iduwhux/drsstc2/tesla_coil_schematic_sketch.pdf

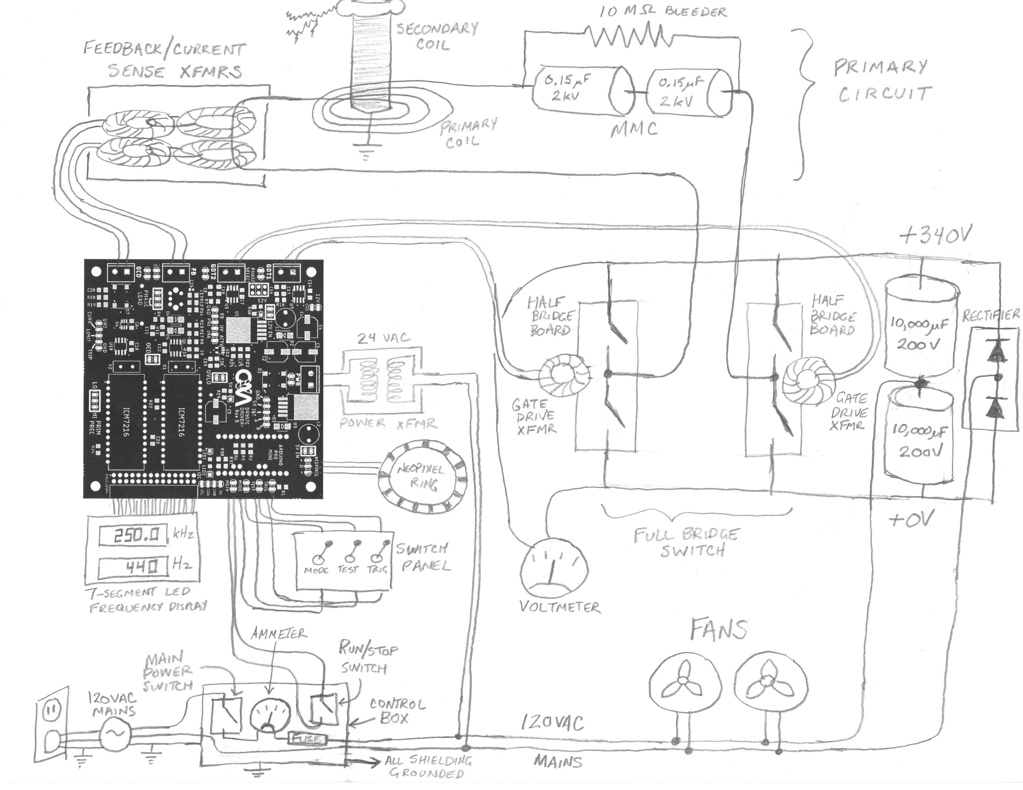
[picture p1: page 1]
