iduwhux/drsstc2/tesla_coil_front_panel_diagram.pdf

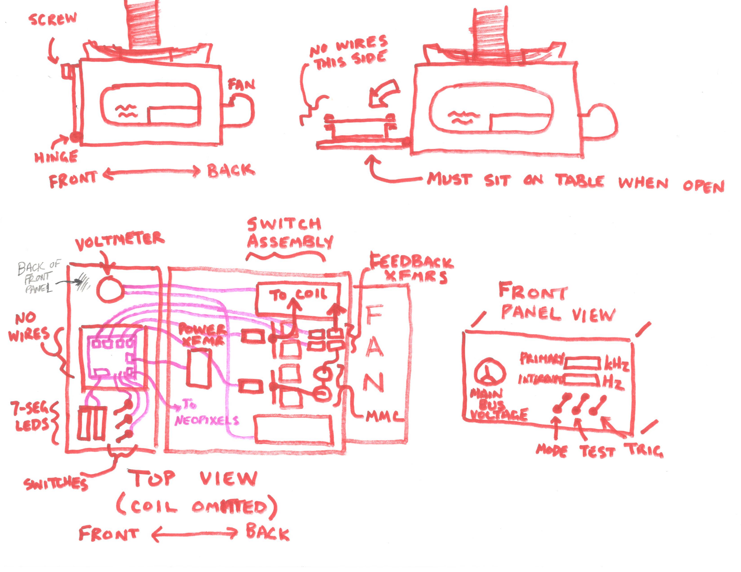
[picture p2: page 1]
