iduwhux/drsstc2/drsstc.png

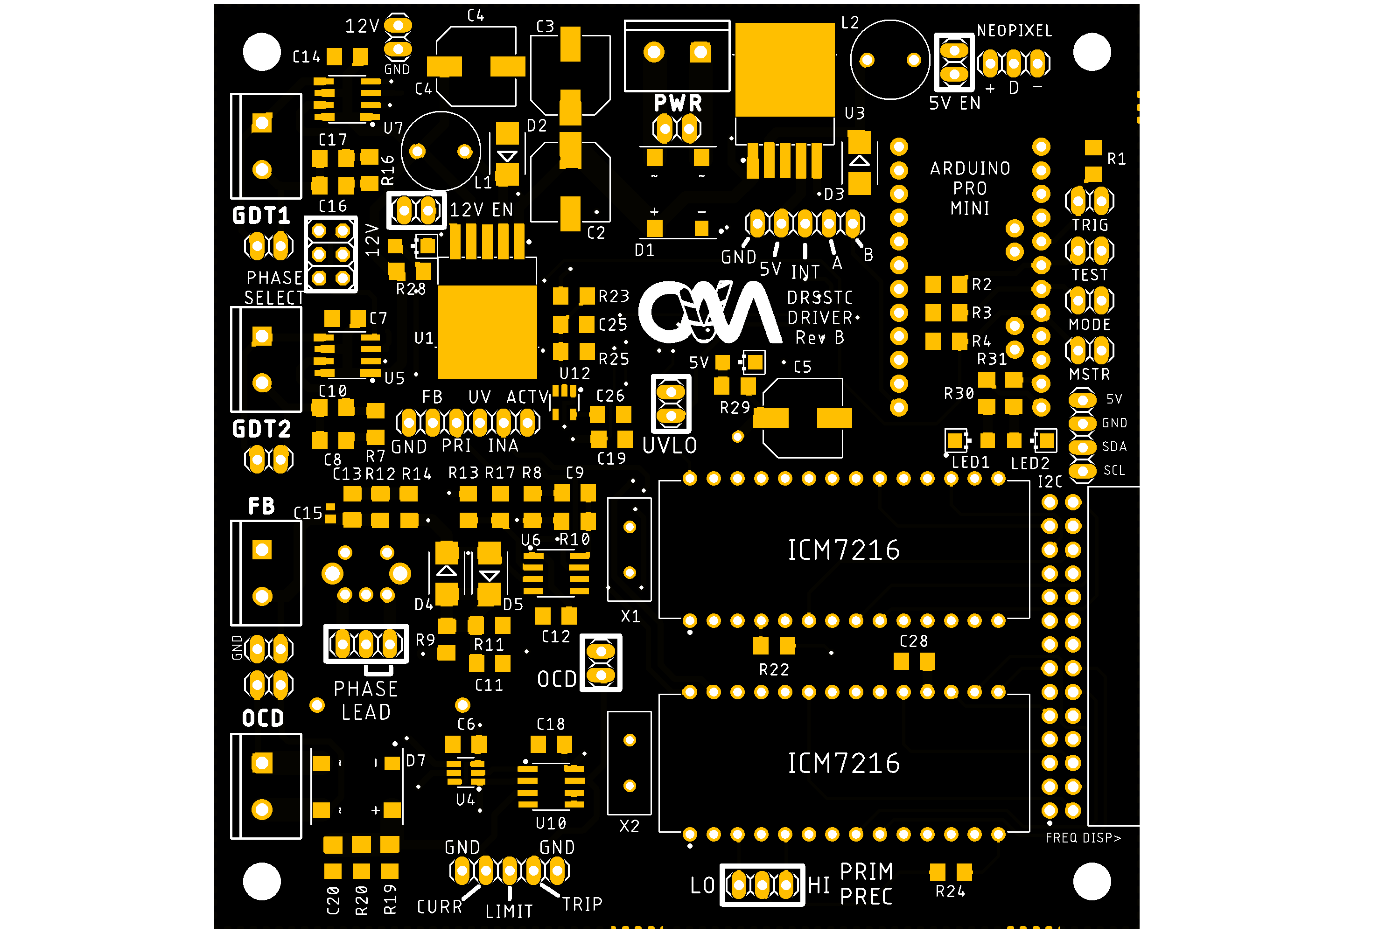
drsstc.png
