iduwhux/drsstc2/drsstc_bottom.png

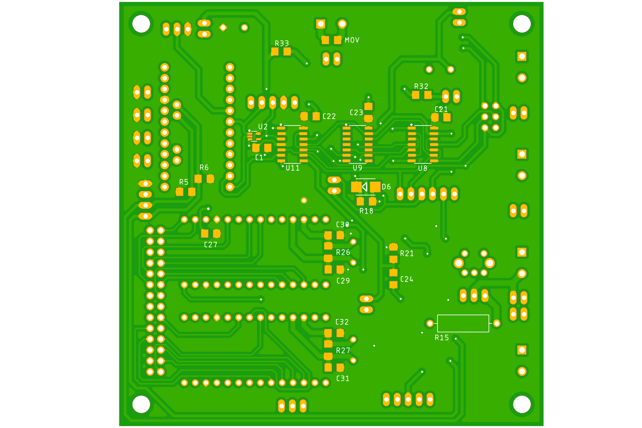
drsstc_bottom.png
