iduwhux/drsstc2/3d_print/BoosterBoardMount.stl

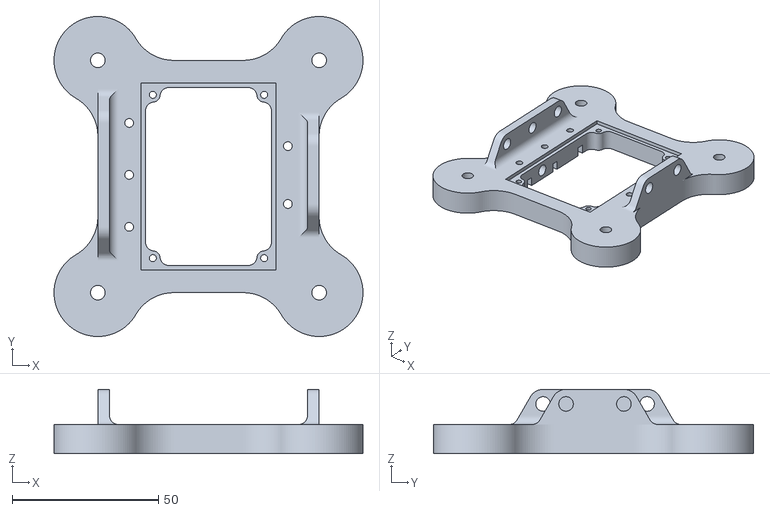
[picture p5: CAD file, 2019-06-07]
3d_print/BoosterBoardMount.stl
105.7 x 109.5 x 22.0
