iduwhux/drsstc2/laser/bus_bars_mount_top.dxf

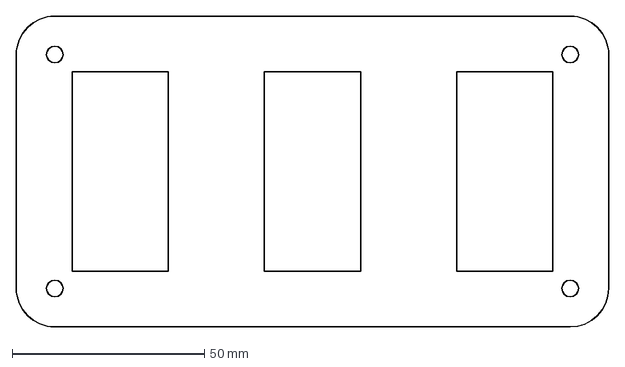
[picture p6: CAD file, 2019-06-10]
laser/bus_bars_mount_top.dxf
154.0 x 80.8 mm
