iduwhux/drsstc2/laser/control box/control_box_top.dxf

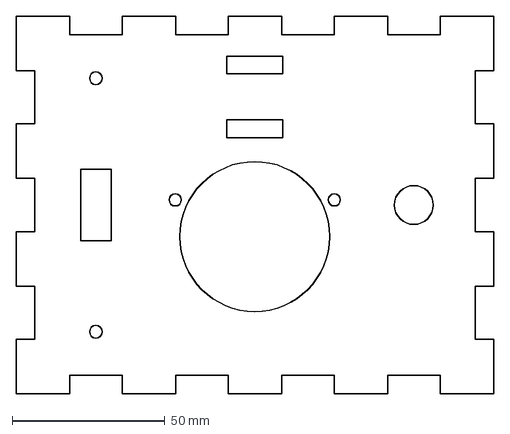
[picture p7: CAD file, 2019-06-20]
laser/control box/control_box_top.dxf
156.1 x 123.4 mm
