iduwhux/drsstc2/rf_shield/logic_board_rf_shield_alignment.dxf

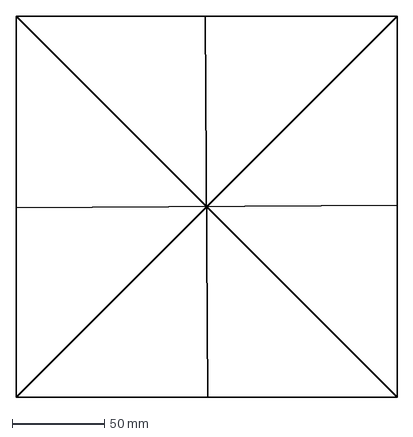
[picture p8: CAD file, 2019-03-26]
rf_shield/logic_board_rf_shield_alignment.dxf
206.6 x 206.6 mm
