iduwhux/drsstc2/Switch Housing Acrylic/1 - HS Seat Front.dxf

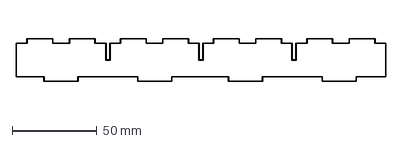
[picture p9: CAD file, 2019-03-31]
Switch Housing Acrylic/1 - HS Seat Front.dxf
218.6 x 25.1 mm
