iduwhux/drsstc2/TO-247 v20.step

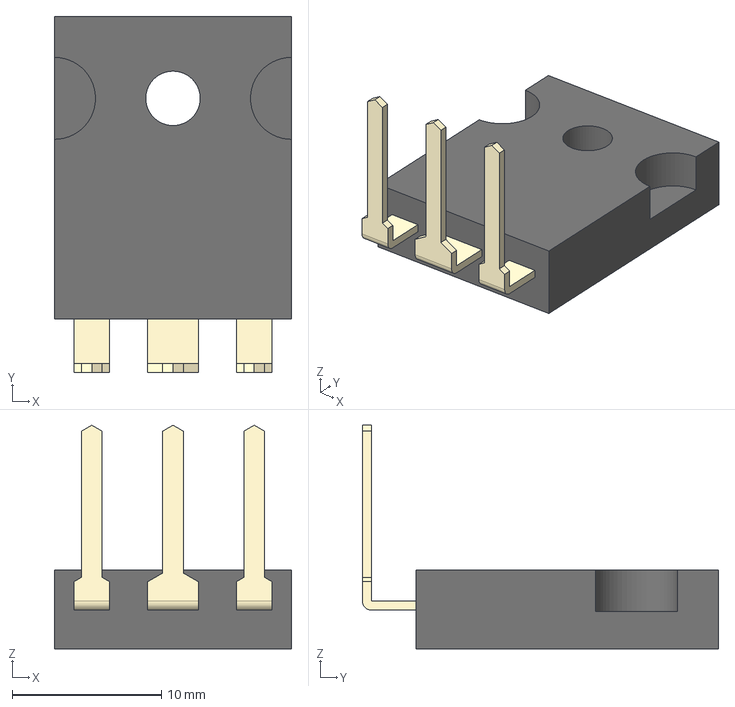
[picture p10: CAD file, 2019-03-26]
TO-247 v20.step
15.9 x 23.9 x 15.0 mm
