iduwhux/drsstc2/3d_print/LogicBoardMount.stl

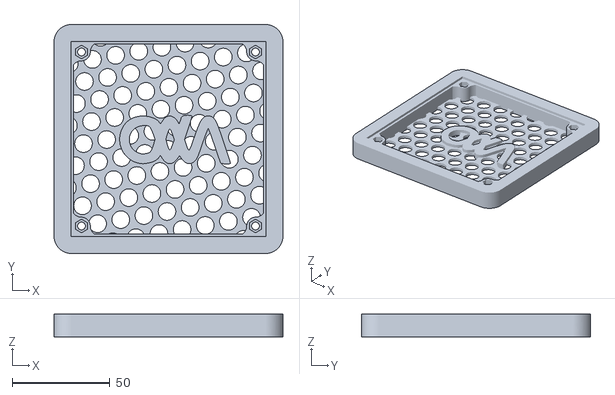
[picture p11: CAD file, 2019-06-07]
3d_print/LogicBoardMount.stl
117.0 x 117.0 x 11.6
