iduwhux/drsstc2/laser/control box/control_box_fuse_support.dxf

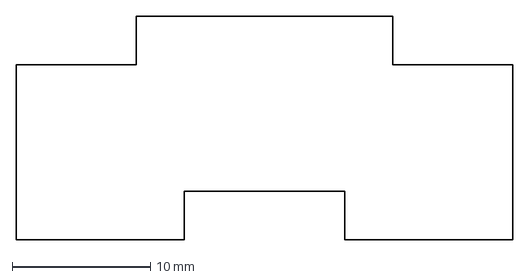
[picture p13: CAD file, 2019-06-12]
laser/control box/control_box_fuse_support.dxf
35.9 x 16.1 mm
