iduwhux/drsstc2/LED v1.step

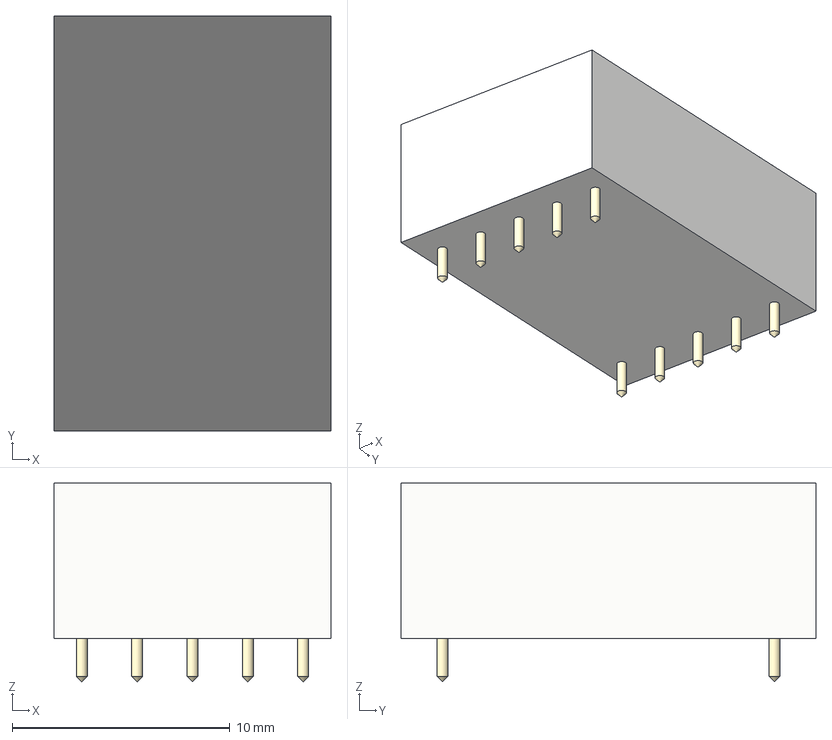
[picture p14: CAD file, 2018-12-22]
LED v1.step
12.7 x 19.1 x 9.13 mm
