iduwhux/drsstc2/rf_shield/logic_board_rf_shield_handle.dxf

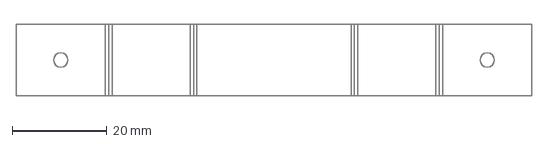
[picture p15: CAD file, 2019-03-26]
rf_shield/logic_board_rf_shield_handle.dxf
108.6 x 15.0 mm
