iduwhux/drsstc2/Switch Housing Acrylic/12 - Middle Plane.dxf

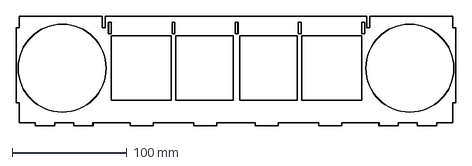
[picture p16: CAD file, 2019-03-31]
Switch Housing Acrylic/12 - Middle Plane.dxf
383.3 x 95.3 mm
