iduwhux/drsstc2/drsstc.dxf

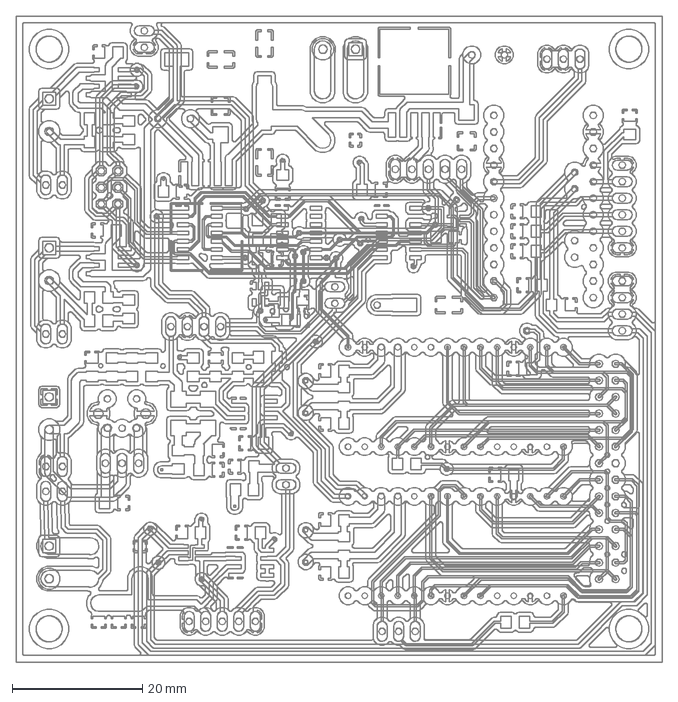
[picture p17: CAD file, 2018-12-22]
drsstc.dxf
99.1 x 99.1 mm
