iduwhux/drsstc2/laser/control box/control_box_fuse_mount.dxf

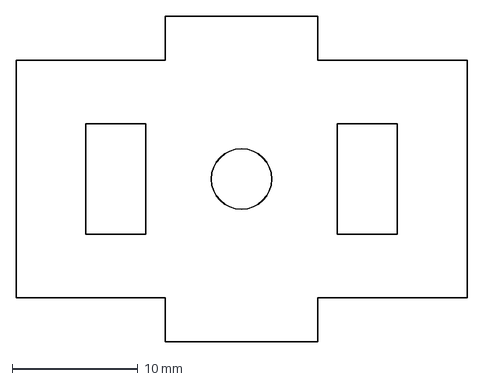
[picture p18: CAD file, 2019-06-12]
laser/control box/control_box_fuse_mount.dxf
35.9 x 25.9 mm
