iduwhux/drsstc2/laser/side_panel_final.dxf

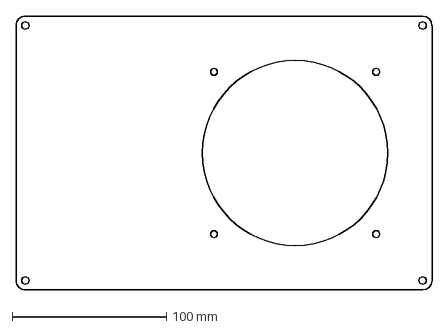
[picture p19: CAD file, 2019-06-07]
laser/side_panel_final.dxf
269.4 x 177.3 mm
