iduwhux/drsstc2/rf_shield/logic_board_rf_shield.dxf

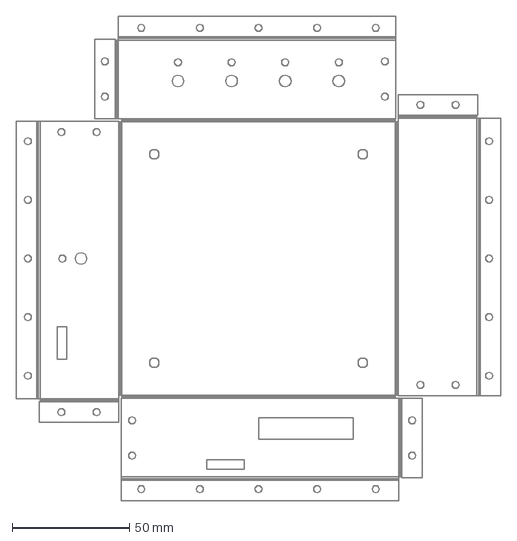
[picture p20: CAD file, 2019-03-26]
rf_shield/logic_board_rf_shield.dxf
206.6 x 206.6 mm
