iduwhux/drsstc2/Switch Housing Acrylic/19 - Right Side.dxf

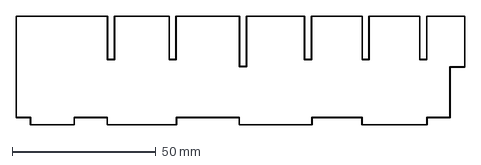
[picture p21: CAD file, 2019-03-31]
Switch Housing Acrylic/19 - Right Side.dxf
155.9 x 37.8 mm
