iduwhux/drsstc2/laser/control box/control_box_right.dxf

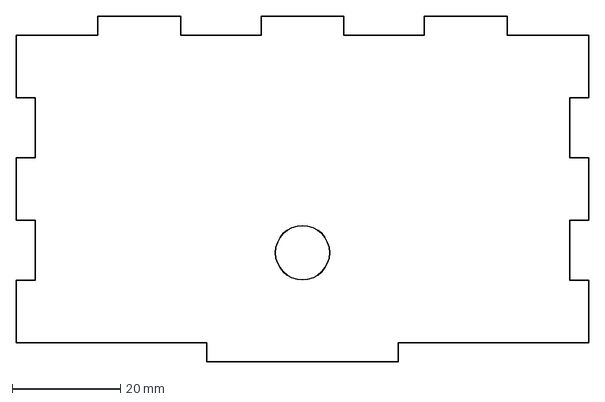
[picture p22: CAD file, 2019-06-12]
laser/control box/control_box_right.dxf
105.7 x 63.8 mm
