iduwhux/drsstc2/laser/side_panel_outline.dxf

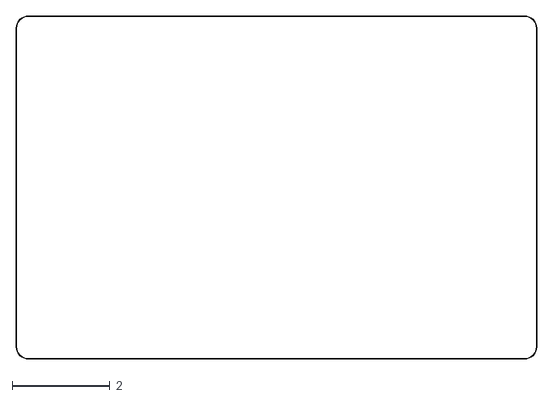
[picture p23: CAD file, 2019-06-07]
laser/side_panel_outline.dxf
10.6 x 7.00
