iduwhux/drsstc2/rf_shield/logic_board_rf_shield_top.dxf

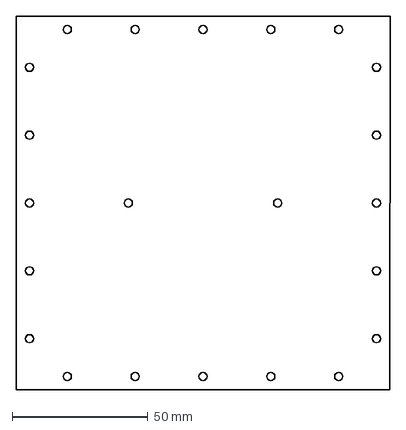
[picture p24: CAD file, 2019-03-26]
rf_shield/logic_board_rf_shield_top.dxf
137.8 x 137.8 mm
