iduwhux/drsstc2/Switch Housing Acrylic/10,11 - Left Cap Brace 1 and 2.dxf

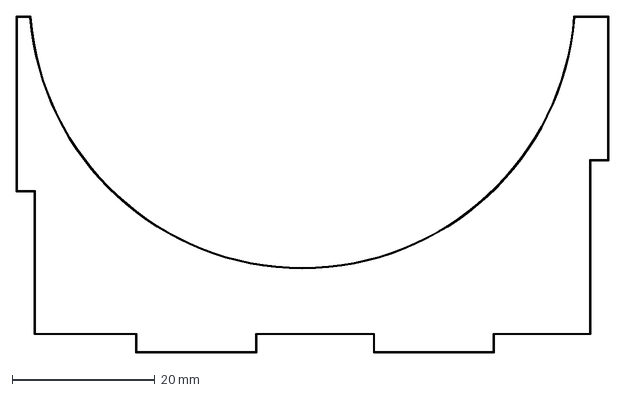
[picture p25: CAD file, 2019-03-31]
Switch Housing Acrylic/10,11 - Left Cap Brace 1 and 2.dxf
83.1 x 47.1 mm
