iduwhux/drsstc2/laser/control box/control_box_front.dxf

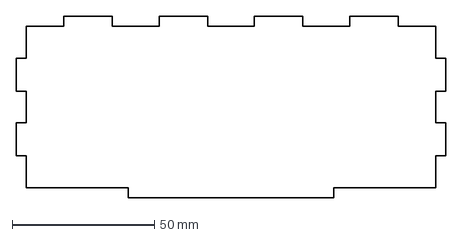
[picture p26: CAD file, 2019-06-12]
laser/control box/control_box_front.dxf
151.1 x 63.8 mm
