iduwhux/drsstc2/laser/ct_vertical.dxf

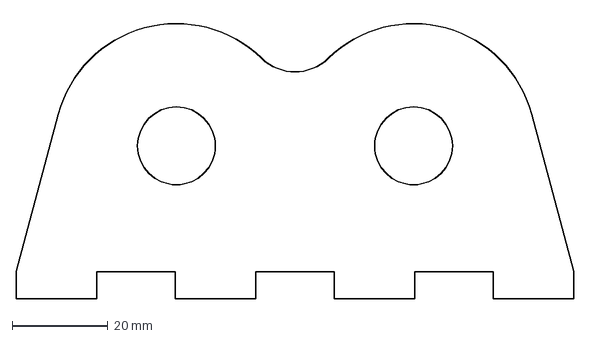
[picture p27: CAD file, 2019-06-01]
laser/ct_vertical.dxf
116.4 x 58.9 mm
