iduwhux/drsstc2/Switch Housing Acrylic/7,8 - Right Cap Brace 1 and 2.dxf

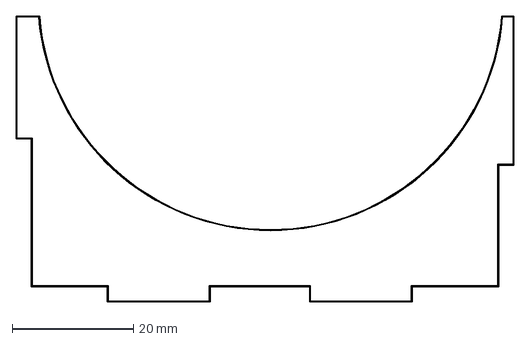
[picture p28: CAD file, 2019-03-31]
Switch Housing Acrylic/7,8 - Right Cap Brace 1 and 2.dxf
82.1 x 47.1 mm
