iduwhux/drsstc2/laser/control box/control_box_bottom.dxf

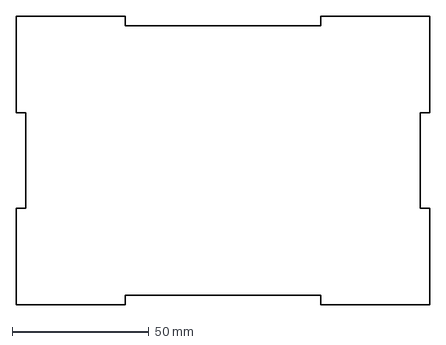
[picture p29: CAD file, 2019-06-12]
laser/control box/control_box_bottom.dxf
151.1 x 105.7 mm
