iduwhux/drsstc2/laser/ct_horizontal.dxf

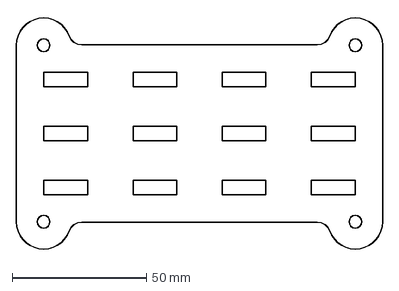
[picture p30: CAD file, 2019-06-01]
laser/ct_horizontal.dxf
136.4 x 87.4 mm
