iduwhux/drsstc2/Switch Housing Acrylic/20,21,22 - Right Cap Brace 3,4,5.dxf

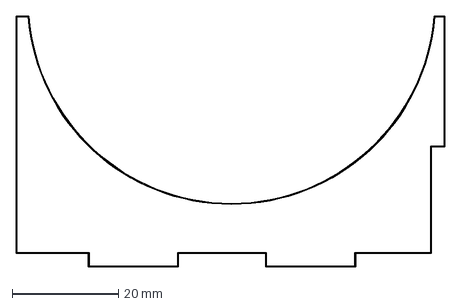
[picture p31: CAD file, 2019-03-31]
Switch Housing Acrylic/20,21,22 - Right Cap Brace 3,4,5.dxf
80.6 x 47.1 mm
