iduwhux/drsstc2/laser/airway_cover_separator.dxf

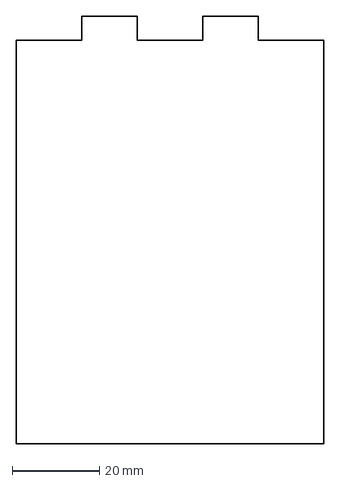
[picture p32: CAD file, 2019-05-31]
laser/airway_cover_separator.dxf
70.5 x 98.0 mm
