iduwhux/drsstc2/Switch Housing Acrylic/23 - Left Side.dxf

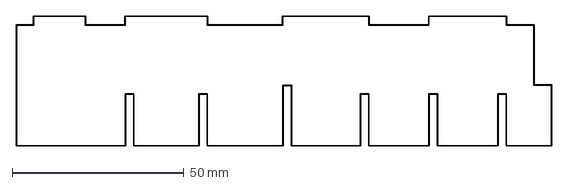
[picture p33: CAD file, 2019-03-31]
Switch Housing Acrylic/23 - Left Side.dxf
155.9 x 37.8 mm
