iduwhux/drsstc2/laser/airway_cover_top.dxf

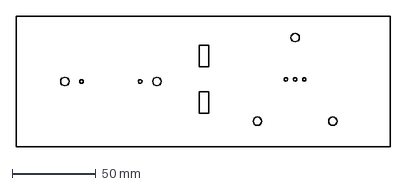
[picture p34: CAD file, 2019-05-31]
laser/airway_cover_top.dxf
223.4 x 78.2 mm
