iduwhux/drsstc2/Switch Housing Acrylic/3,4 - Left Right Dividers.dxf

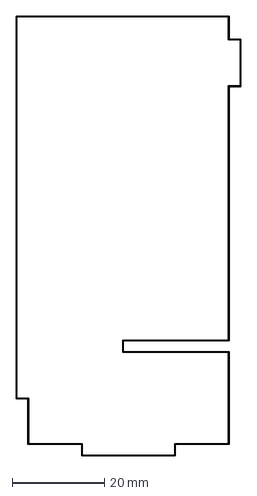
[picture p35: CAD file, 2019-03-31]
Switch Housing Acrylic/3,4 - Left Right Dividers.dxf
48.6 x 95.3 mm
