iduwhux/drsstc2/laser/freq_display_front.dxf

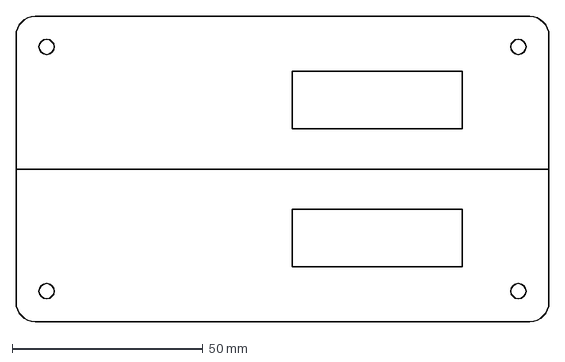
[picture p36: CAD file, 2018-12-22]
laser/freq_display_front.dxf
139.7 x 80.0 mm
