iduwhux/drsstc2/Switch Housing Acrylic/13 - Back Plane 1.dxf

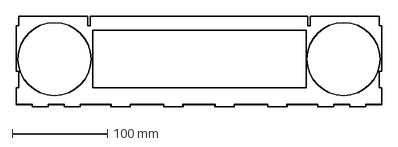
[picture p37: CAD file, 2019-03-31]
Switch Housing Acrylic/13 - Back Plane 1.dxf
383.3 x 95.3 mm
