iduwhux/drsstc2/laser/freq_display_back.dxf

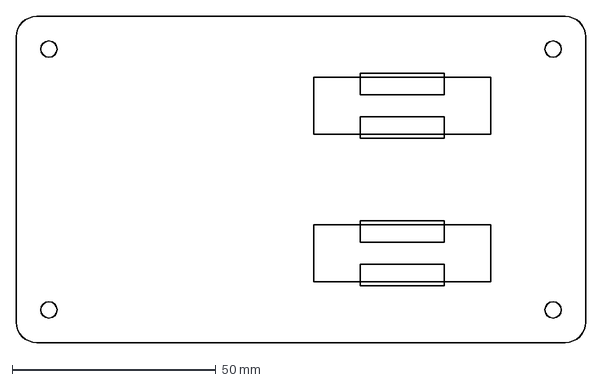
[picture p38: CAD file, 2018-12-22]
laser/freq_display_back.dxf
139.7 x 80.0 mm
