iduwhux/drsstc2/Switch Housing Acrylic/6 - Right Cap Divider.dxf

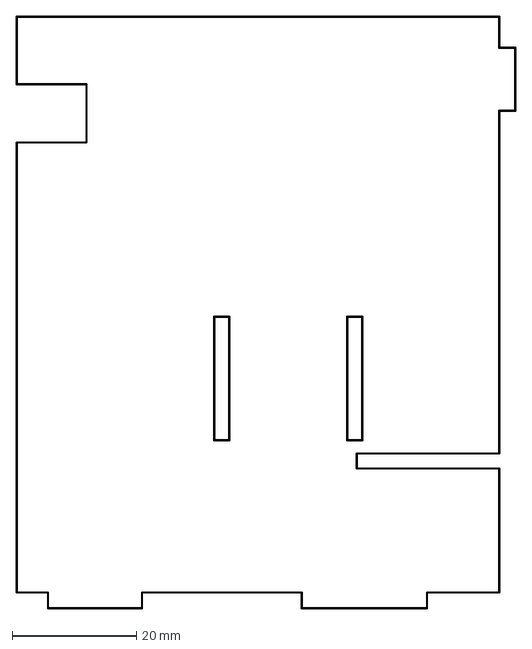
[picture p39: CAD file, 2019-03-31]
Switch Housing Acrylic/6 - Right Cap Divider.dxf
80.3 x 95.3 mm
