iduwhux/drsstc2/Switch Housing Acrylic/24,25,26 - Left Cap Brace 3,4,5.dxf

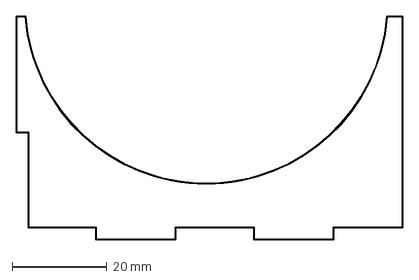
[picture p40: CAD file, 2019-03-31]
Switch Housing Acrylic/24,25,26 - Left Cap Brace 3,4,5.dxf
81.6 x 47.1 mm
