iduwhux/drsstc2/Switch Housing Acrylic/14 - Back Plane 2.dxf

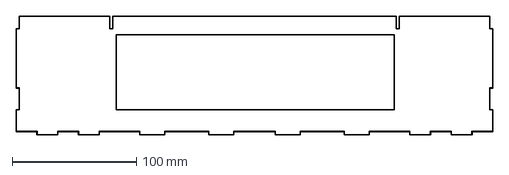
[picture p41: CAD file, 2019-03-31]
Switch Housing Acrylic/14 - Back Plane 2.dxf
383.3 x 95.3 mm
