iduwhux/drsstc2/Switch Housing Acrylic/5 - HS Seat Floor.dxf

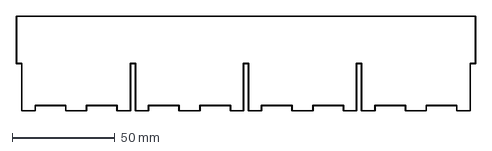
[picture p42: CAD file, 2019-03-31]
Switch Housing Acrylic/5 - HS Seat Floor.dxf
223.6 x 46.1 mm
