iduwhux/drsstc2/Switch Housing Acrylic/9 - Left Cap Divider.dxf

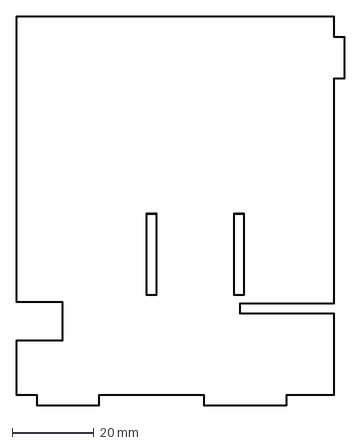
[picture p43: CAD file, 2019-03-31]
Switch Housing Acrylic/9 - Left Cap Divider.dxf
80.3 x 95.3 mm
