iduwhux/drsstc2/Switch Housing Acrylic/15,16,17,18 - Top Brace.dxf

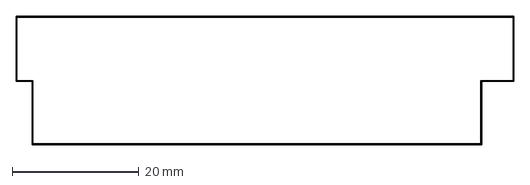
[picture p44: CAD file, 2019-03-31]
Switch Housing Acrylic/15,16,17,18 - Top Brace.dxf
78.4 x 20.3 mm
