iduwhux/drsstc2/Switch Housing Acrylic/2 - Center Divider.dxf

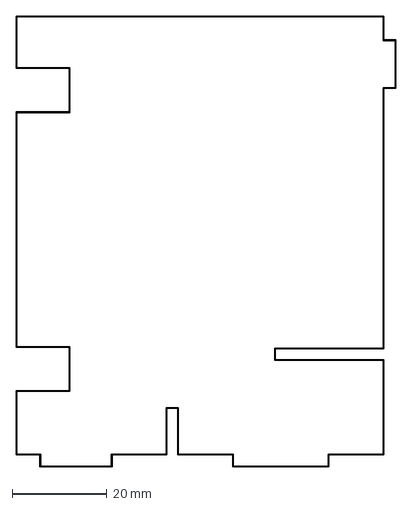
[picture p45: CAD file, 2019-03-31]
Switch Housing Acrylic/2 - Center Divider.dxf
80.3 x 95.3 mm
