iduwhux/drsstc2/Switch Housing Acrylic/0 - Floor.dxf

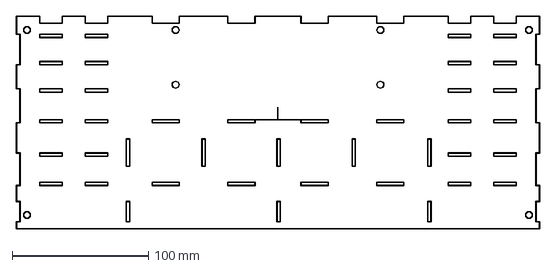
[picture p46: CAD file, 2019-03-31]
Switch Housing Acrylic/0 - Floor.dxf
383.3 x 155.9 mm
