iduwhux/drsstc2/(list of files, cad)

Other CAD files:
LED v1.f3d
