iduwhux/drsstc2/rf_shield/logic_board_rf_shield.pdf

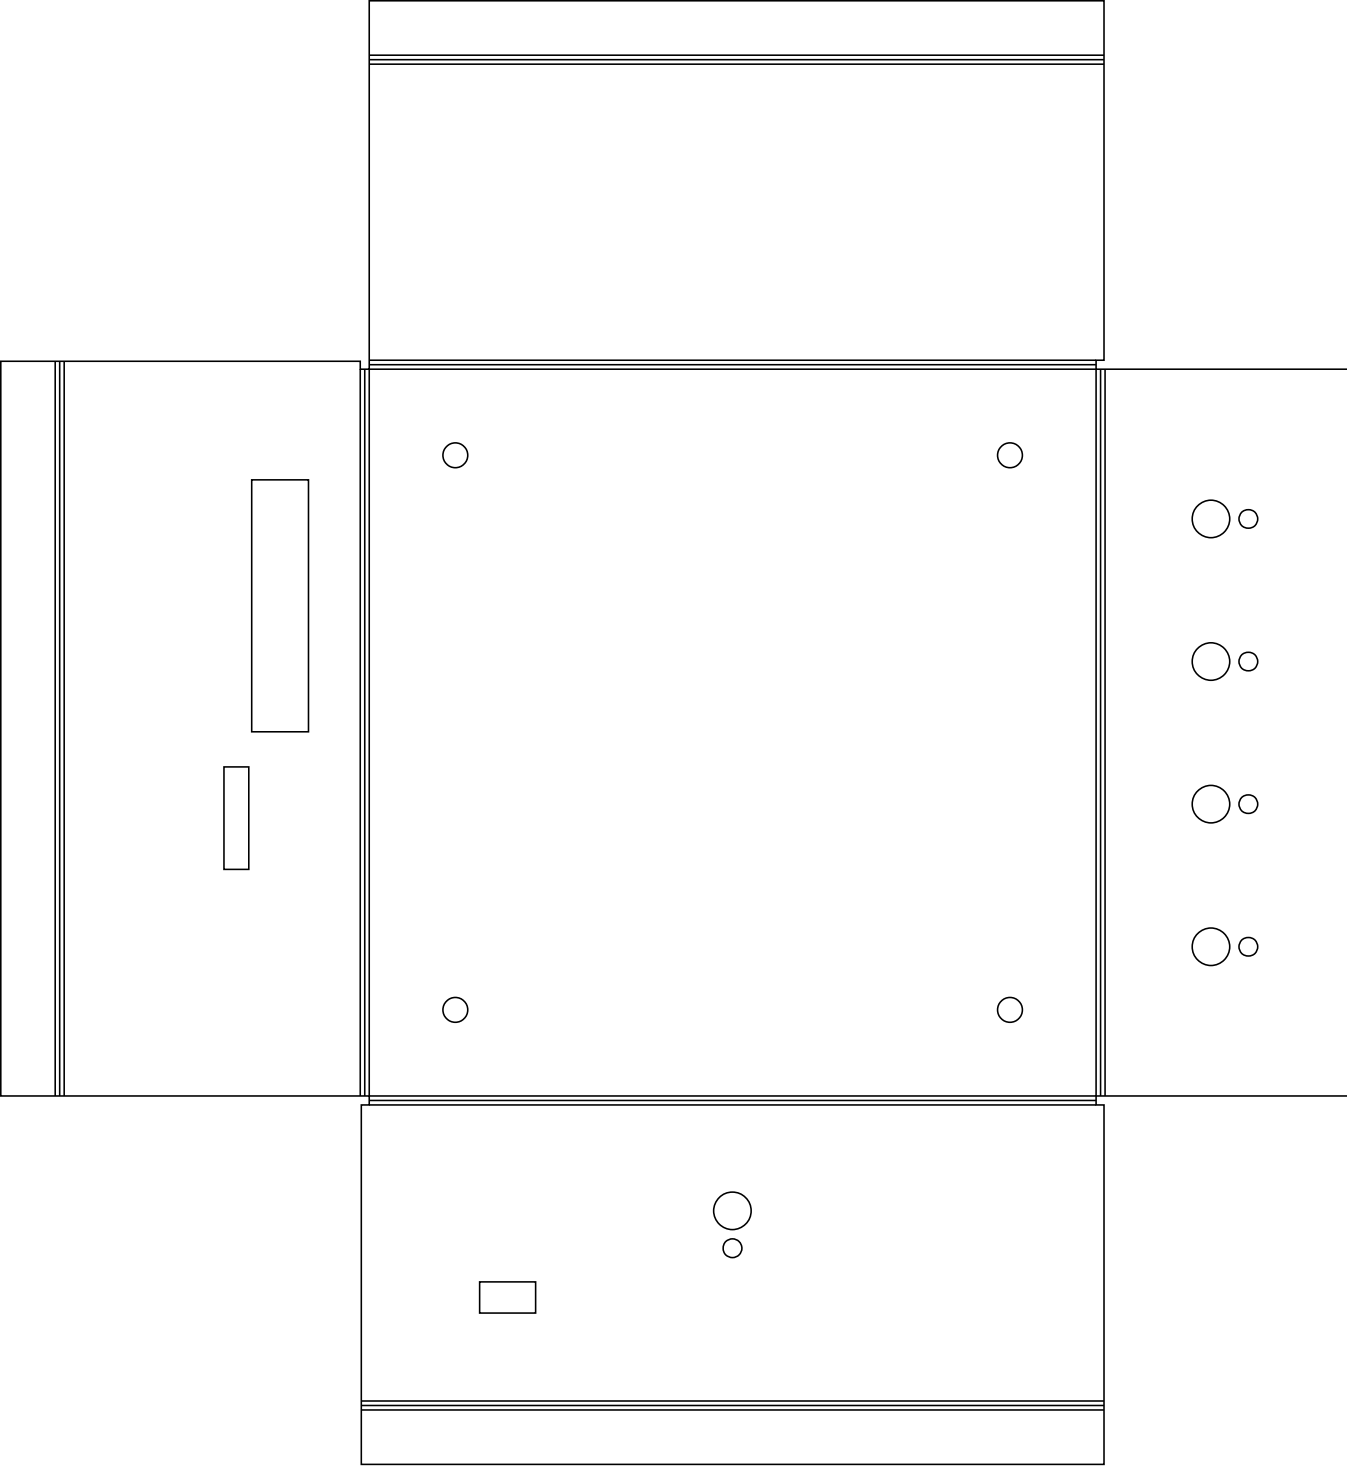
[picture p47: page 1]
