iduwhux/drsstc2/booster.brd

## EAGLE design booster.brd (2019-06-01)

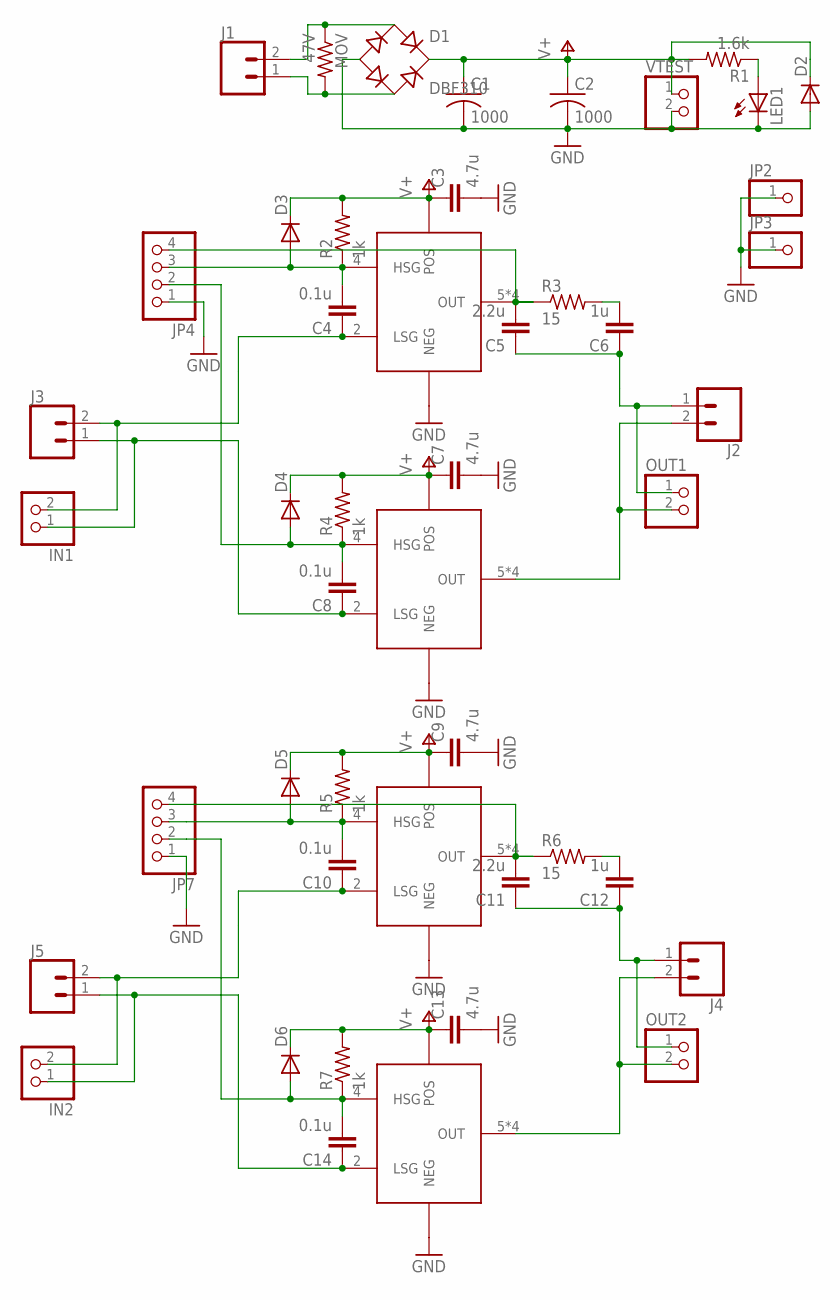
[picture p48: schematic booster.sch]

Parts:
C1, C2: 1000; CAPPRD500W65D1250H2500B
C3, C7, C9, C13: 4.7u; C1206
C4, C8, C10, C14: 0.1u; C1206
C5, C11: 2.2u; C1206
C6, C12: 1u; C1206
D1: DBF310; 4-SMD
D2, D3, D4, D5, D6: DIODE-SMB; SMB
IN1, IN2: PINHD-1X2; 1X02
J1, J2, J3, J4, J5: CONN_025MM; SCREWTERMINAL-5MM-2
JP2, JP3: PINHD-1X1; 1X01
JP4, JP7: PINHD-1X4; 1X04
LED1: LED5MM
MOV: 47V; R1206
OUT1, OUT2: PINHD-1X2; 1X02
R1: 1.6k; R2512
R2, R4, R5, R7: 1k; R1206
R3, R6: 15; R1206
U1, U2, U3, U4: SI4554DY; SOIC-8
VTEST: PINHD-1X2; 1X02

Connections:
GND: C1.2, C2.2, C3.2, C7.2, C9.2, C13.2, D1.-, D2.A, JP2.1, JP3.1, JP4.1, JP7.1, LED1.K (C), U1.1 (NEG), U2.1 (NEG), U3.1 (NEG), U4.1 (NEG), VTEST.2
unnamed: LED1.A, R1.1
unnamed: C5.2, JP4.4, R3.1, U1.5 (OUT), U1.6 (OUT), U1.7 (OUT), U1.8 (OUT)
unnamed: D1.~1 (AC1), J1.2, MOV.1
unnamed: C6.2, R3.2
unnamed: C5.1, C6.1, J2.1, OUT1.1
unnamed: J2.2, OUT1.2, U2.5 (OUT), U2.6 (OUT), U2.7 (OUT), U2.8 (OUT)
unnamed: C4.1, IN1.2, J3.2, U1.2 (LSG)
unnamed: C4.2, D3.A, JP4.3, R2.1, U1.4 (HSG)
unnamed: C11.2, JP7.4, R6.1, U3.5 (OUT), U3.6 (OUT), U3.7 (OUT), U3.8 (OUT)
unnamed: C12.2, R6.2
unnamed: C8.1, IN1.1, J3.1, U2.2 (LSG)
unnamed: C8.2, D4.A, JP4.2, R4.1, U2.4 (HSG)
unnamed: C11.1, C12.1, J4.1, OUT2.1
unnamed: C10.1, IN2.2, J5.2, U3.2 (LSG)
unnamed: C10.2, D5.A, JP7.3, R5.1, U3.4 (HSG)
unnamed: C14.1, IN2.1, J5.1, U4.2 (LSG)
unnamed: C14.2, D6.A, JP7.2, R7.1, U4.4 (HSG)
unnamed: J4.2, OUT2.2, U4.5 (OUT), U4.6 (OUT), U4.7 (OUT), U4.8 (OUT)
unnamed: D1.~2 (AC2), J1.1, MOV.2
V+: C1.1, C2.1, C3.1, C7.1, C9.1, C13.1, D1.+, D2.C, D3.C, D4.C, D5.C, D6.C, R1.2, R2.2, R4.2, R5.2, R7.2, U1.3 (POS), U2.3 (POS), U3.3 (POS), U4.3 (POS), VTEST.1

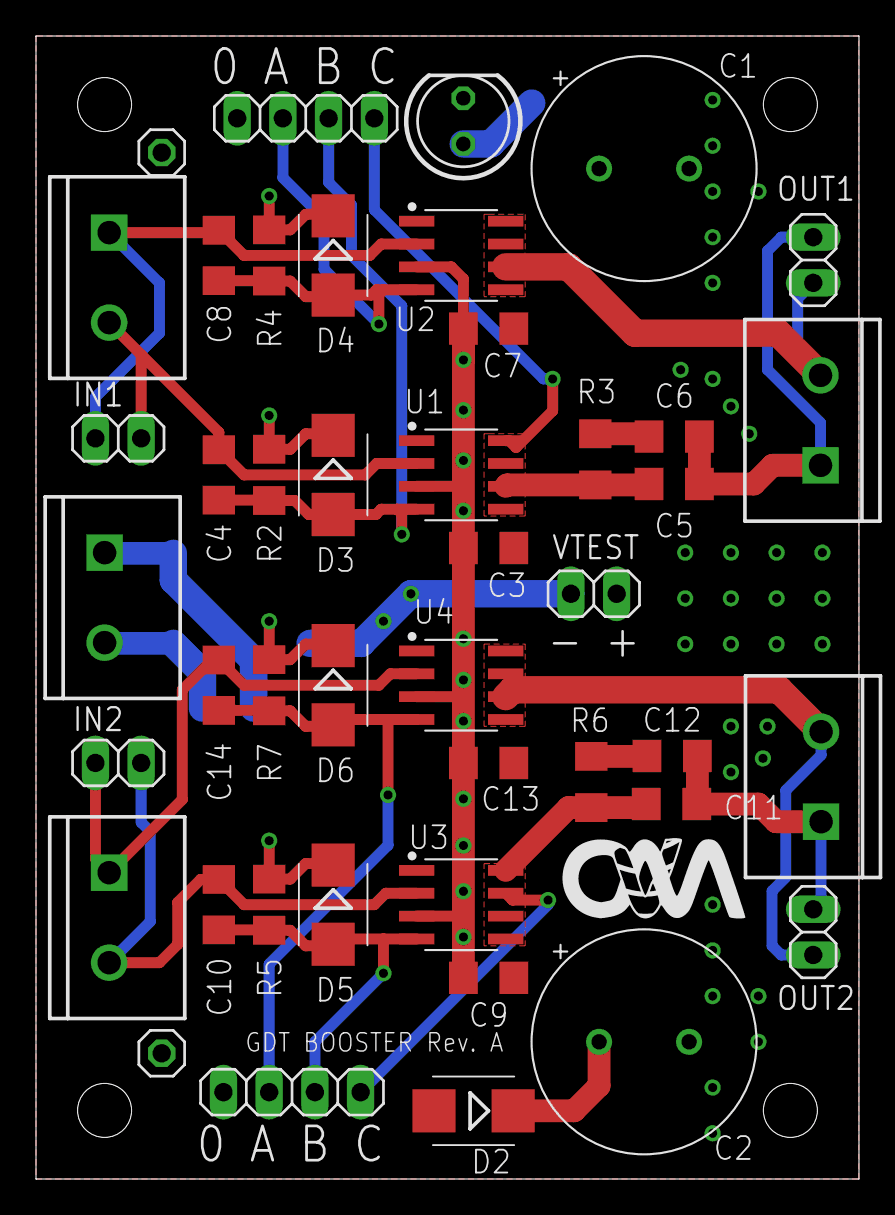
[picture p49: board booster.brd from above]

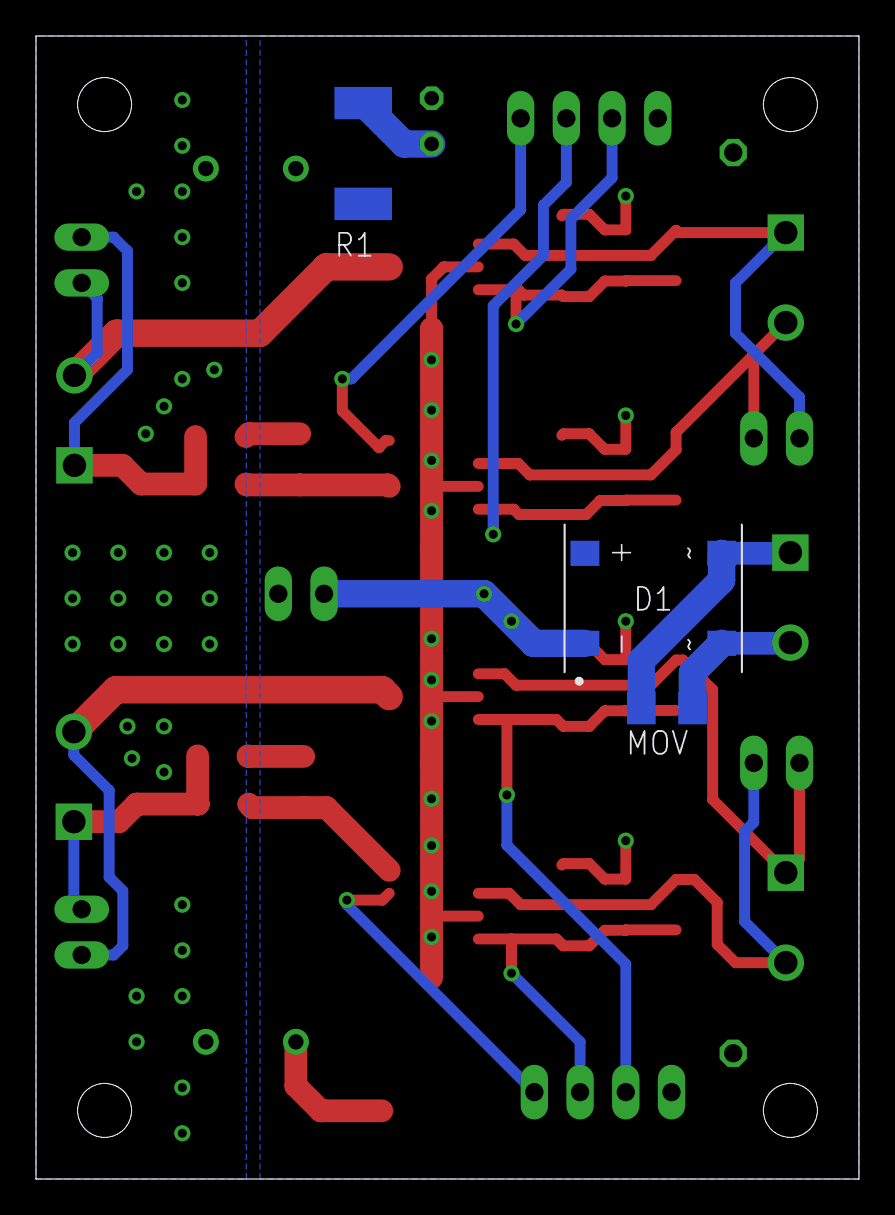
[picture p50: board booster.brd from below]

Board: 2 copper layers, 45.7 x 63.5 mm, 47 parts (3 on the bottom side), 21 nets.
