iduwhux/drsstc2/drsstc.brd

## EAGLE design drsstc.brd (2019-04-14)

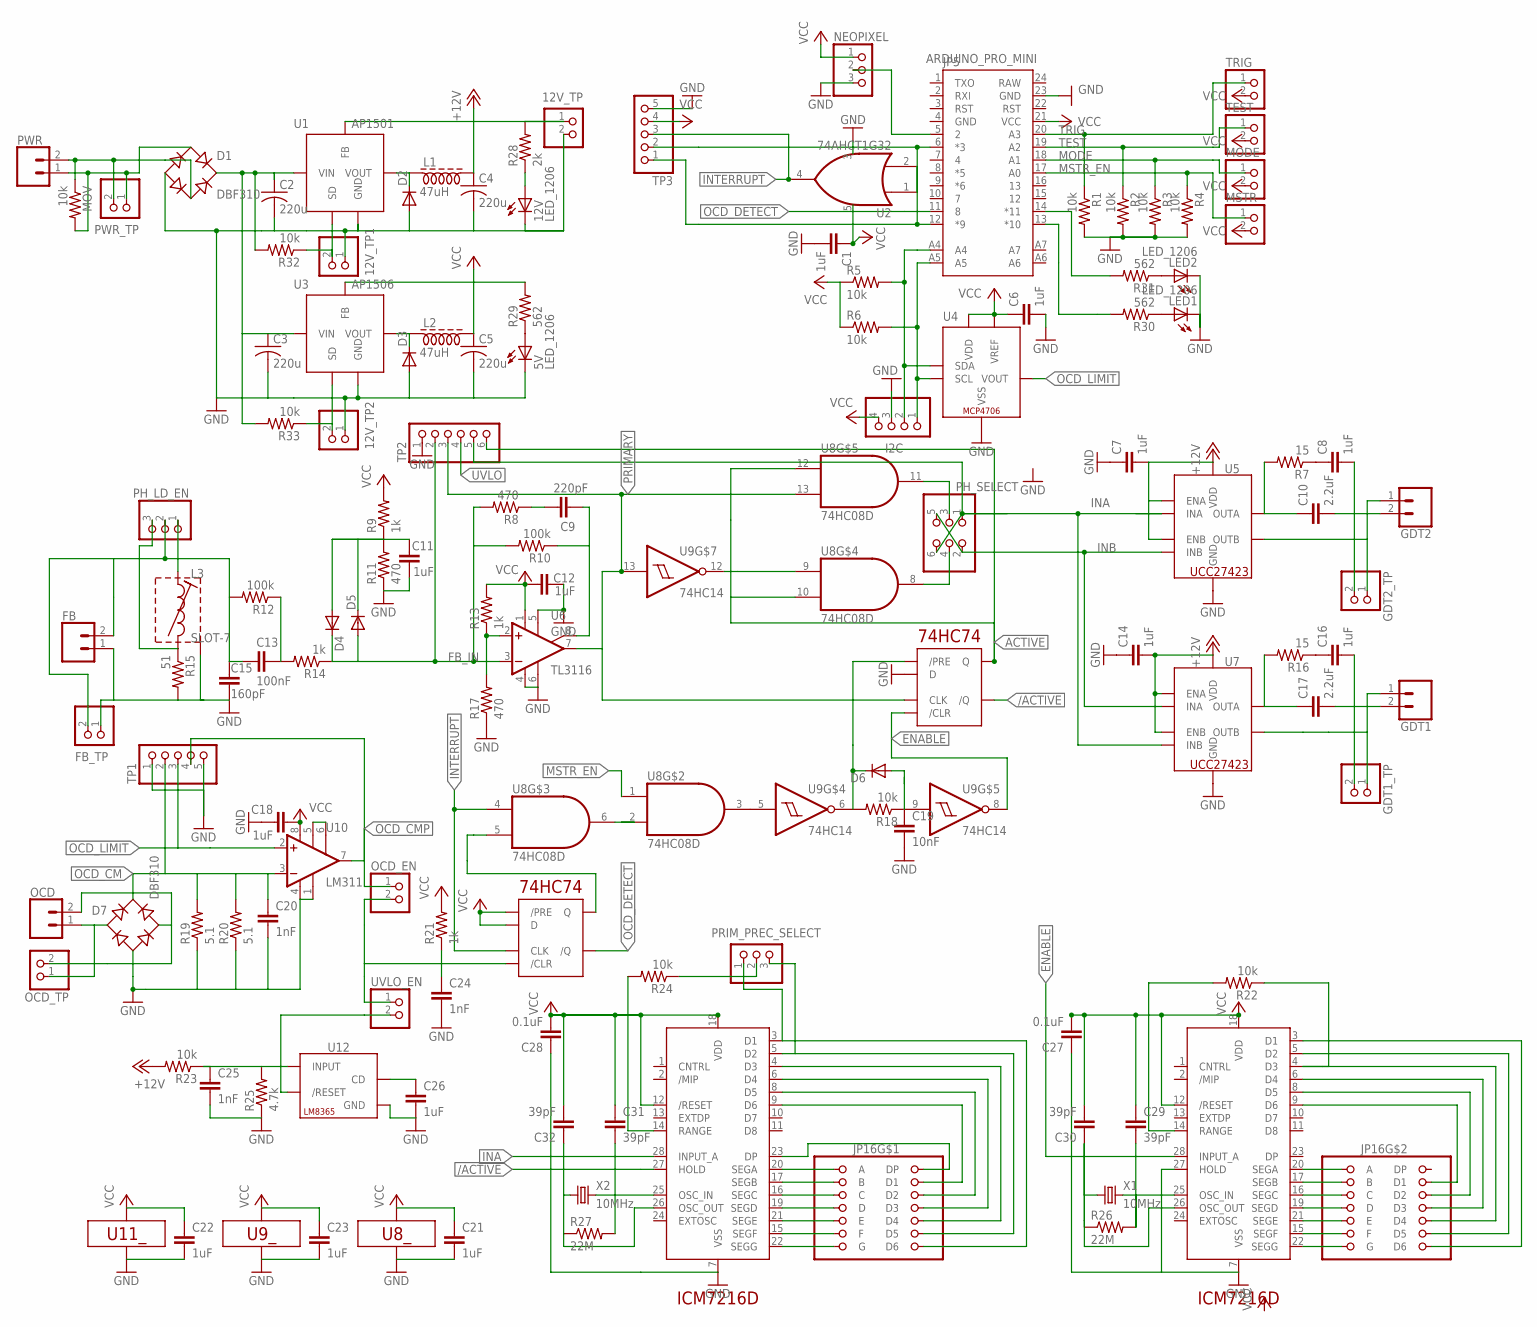
[picture p51: schematic drsstc.sch]

Parts:
5V, 12V: LED_1206; CHIPLED_1206
12V_TP, 12V_TP1, 12V_TP2: PINHD-1X2; 1X02
C1, C6, C7, C8, C11, C12, C14, C16, C18, C21, C22, C23, C26: 1uF; C1206
C2, C3, C4, C5: 220u; CAPAE830X1050
C9: 220pF; C1206
C10, C17: 2.2uF; C1206
C13: 100nF; C1206
C15: 160pF; C0402
C19: 10nF; C1206
C20, C24, C25: 1nF; C1206
C27, C28: 0.1uF; C1206
C29, C30, C31, C32: 39pF; C1206
D1, D7: DBF310; 4-SMD
D2, D3, D4, D5, D6: DIODE-SMB; SMB
FB: CONN_025MM; SCREWTERMINAL-5MM-2
FB_TP: PINHD-1X2; 1X02
GDT1, GDT2: CONN_025MM; SCREWTERMINAL-5MM-2
GDT1_TP, GDT2_TP: PINHD-1X2; 1X02
I2C: PINHD-1X4; 1X04
JP5: ARDUINO_PRO_MINI
JP16: LED_HDR; HDRRAR28W64P254_2X14_3606X850X508B
L1, L2: 47uH; RLB9013
L3: SLOT-7
LED1, LED2: LED_1206; CHIPLED_1206
MODE: PINHD-1X2; 1X02
MOV: 10k; R1206
MSTR: PINHD-1X2; 1X02
NEOPIXEL: PINHD-1X3; 1X03
OCD: CONN_025MM; SCREWTERMINAL-5MM-2
OCD_EN: PINHD-1X2; 1X02
OCD_TP: PINHD-1X2; 1X02
PH_LD_EN: PINHD-1X3; 1X03
PH_SELECT: PINHD-2X3; 2X03
PRIM_PREC_SELECT: PINHD-1X3; 1X03
PWR: CONN_025MM; SCREWTERMINAL-5MM-2
PWR_TP: PINHD-1X2; 1X02
R1, R2, R3, R4, R5, R6, R18, R22, R23, R24, R32, R33: 10k; R1206
R7, R16: 15; R1206
R8, R11, R17: 470; R1206
R9, R13, R14, R21: 1k; R1206
R10, R12: 100k; R1206
R15: 51; RESAD1560W80L1200D400B
R19, R20: 5.1; R1206
R25: 4.7k; R1206
R26, R27: 22M; R1206
R28: 2k; R1206
R29, R30, R31: 562; R1206
TEST: PINHD-1X2; 1X02
TP1, TP3: PINHD-1X5; 1X05
TP2: PINHD-1X6; 1X06
TRIG: PINHD-1X2; 1X02
U1: AP1501; TO-263-5
U2: 74AHCT1G32; SOT353
U3: AP1506; TO-263-5
U4: MCP4706; SOT-23-6
U5, U7: UCC27423; SOIC-8
U6: TL3116; SOIC-8
U8: 74HC08D; SOIC-14
U9: 74HC14; SOIC-14
U10: LM311; SOIC-8
U11: 74HC74; SOIC-14
U12: LM8365; SOT-23-5
U13, U14: ICM7216D; DIP1524W55P254L3740H635Q28B
UVLO_EN: PINHD-1X2; 1X02
X1, X2: 10MHz; XTAL

Connections:
+12V: 12V_TP.1, C4.1, C7.2, C14.2, L1.P$2 (2), R23.2, R28.2, U1.4 (FB), U5.1 (ENA), U5.6 (VDD), U5.8 (ENB), U7.1 (ENA), U7.6 (VDD), U7.8 (ENB)
/ACTIVE: U11.8 (/Q), U14.27 (HOLD)
ACTIVE: TP2.6, U8.10 (I1), U8.12 (I0), U11.9 (Q)
D1: JP16.1 (D6), PRIM_PREC_SELECT.1, U14.3 (D1)
D2: JP16.2 (D5), PRIM_PREC_SELECT.3, U14.5 (D2)
D4: JP16.3 (D4), U14.4 (D3)
ENABLE: U9.8 (O), U11.13 (/CLR), U13.28 (INPUT_A)
FB_IN: D4.C, D5.A, R8.2, R10.2, R14.1, TP2.2, U6.3 (-IN)
GDT1_1: GDT1.1, GDT1_TP.1, U7.5 (OUTB)
GDT1_2: C16.2, C17.2, GDT1.2, GDT1_TP.2
GDT2_1: GDT2.1, GDT2_TP.1, U5.5 (OUTB)
GDT2_2: C8.2, C10.2, GDT2.2, GDT2_TP.2
GND: 5V.C, 12V.C, 12V_TP.2, 12V_TP1.1, 12V_TP2.1, C1.2, C2.2, C3.2, C4.2, C5.2, C6.2, C7.1, C11.1, C12.2, C14.1, C15.2, C18.1, C19.2, C20.2, C21.2, C22.2, C23.2, C24.2, C25.2, C26.2, C27.1, C28.1, D1.-, D2.A, D3.A, D7.-, FB.1, FB_TP.1, I2C.3, JP5.4 (GND), JP5.23 (GND), L3.SHIELD_1 (SHIELD), L3.SHIELD_2 (SHIELD), LED1.C, LED2.C, NEOPIXEL.3, R1.2, R2.2, R3.2, R4.2, R11.1, R15.2, R17.1, R19.1, R20.1, R25.1, TP1.1, TP1.5, TP2.1, TP3.5, U1.3 (GND), U1.6 (GND), U2.3 (GND), U3.3 (GND), U3.6 (GND), U4.2 (VSS), U5.3 (GND), U6.4 (VCC-), U6.5 (LATCH_EN), U6.6 (GND), U7.3 (GND), U8.7 (GND), U9.7 (GND), U10.1 (GND), U10.4 (VCC-), U11.7 (GND), U11.12 (D), U12.3 (GND), U13.7 (VSS), U13.27 (HOLD), U14.7 (VSS)
INA: PH_SELECT.1, PH_SELECT.6, TP2.5, U5.2 (INA), U7.4 (INB), U14.28 (INPUT_A)
INB: PH_SELECT.2, PH_SELECT.5, U5.4 (INB), U7.2 (INA)
INTERRUPT: TP3.3, U2.4 (O), U8.4 (I0), U11.3 (CLK)
MODE: JP5.18 (A1), MODE.1, R3.1
MSTR_EN: JP5.17 (A0), MSTR.1, R4.1, U8.1 (I0)
unnamed: D1.~2 (AC2), MOV.1, PWR.2, PWR_TP.2
unnamed: D7.~1 (AC1), OCD.1, OCD_TP.1
unnamed: JP16.13 (A), U13.20 (SEGA)
unnamed: C26.1, U12.5 (CD)
unnamed: C24.1, OCD_EN.2, R21.1, U11.1 (/CLR), UVLO_EN.1
unnamed: C25.1, R23.1, R25.2, U12.2 (INPUT)
unnamed: U10.5 (BAL), U10.6 (BAL/S)
unnamed: C19.1, D6.A, R18.1, U9.9 (I)
unnamed: U8.9 (I0), U9.12 (O)
unnamed: U8.5 (I1), U11.5 (Q)
unnamed: U8.3 (O), U9.5 (I)
unnamed: D6.C, R18.2, U9.6 (O), U11.10 (/PRE)
unnamed: JP5.5 (2), NEOPIXEL.2
unnamed: D7.~2 (AC2), OCD.2, OCD_TP.2
unnamed: U8.2 (I1), U8.6 (O)
unnamed: PH_SELECT.4, U8.8 (O)
unnamed: PH_SELECT.3, U8.11 (O)
unnamed: 12V.A, R28.1
unnamed: JP5.6 (*3), TP3.2, U2.1 (I0)
unnamed: C13.2, C15.1, FB.2, FB_TP.2, PH_LD_EN.2, R12.2
unnamed: L3.START (2), PH_LD_EN.3, R15.1
unnamed: L3.FINISH (1), PH_LD_EN.1
unnamed: C9.2, R10.1, U6.8 (/Q)
unnamed: C9.1, R8.1
unnamed: C11.2, D4.A, D5.C, R9.1, R11.2
unnamed: R13.1, R17.2, U6.2 (+IN)
unnamed: C13.1, R12.1, R14.2
unnamed: D1.~1 (AC1), MOV.2, PWR.1, PWR_TP.1
unnamed: C8.1, R7.1
unnamed: C10.1, R7.2, U5.7 (OUTA)
unnamed: 5V.A, R29.1
unnamed: LED2.A, R31.1
unnamed: C16.1, R16.1
unnamed: C17.1, R16.2, U7.7 (OUTA)
unnamed: LED1.A, R30.1
unnamed: 12V_TP1.2, R32.1, U1.5 (SD)
unnamed: JP5.12 (*9), TP3.1, U2.2 (I1)
unnamed: C2.1, C3.1, D1.+, R32.2, R33.2, U1.1 (VIN), U3.1 (VIN)
unnamed: D3.C, L2.P$1 (1), U3.2 (VOUT)
unnamed: JP5.13 (*10), R30.2
unnamed: D2.C, L1.P$1 (1), U1.2 (VOUT)
unnamed: C32.1, R27.1, U14.26 (OSC_OUT), X2.P$1 (1)
unnamed: JP5.14 (*11), R31.2
unnamed: R24.2, U14.14 (RANGE)
unnamed: C31.2, R27.2, U14.25 (OSC_IN), X2.P$2 (2)
unnamed: 12V_TP2.2, R33.1, U3.5 (SD)
unnamed: JP16.12 (B), U13.17 (SEGB)
unnamed: JP16.20 (C), U13.16 (SEGC)
unnamed: JP16.19 (D), U13.19 (SEGD)
unnamed: JP16.18 (E), U13.21 (SEGE)
unnamed: R22.2, U13.14 (RANGE)
unnamed: C29.2, R26.2, U13.25 (OSC_IN), X1.P$2 (2)
unnamed: C30.1, R26.1, U13.26 (OSC_OUT), X1.P$1 (1)
unnamed: JP16.14 (F), U13.15 (SEGF)
unnamed: JP16.11 (G), U13.22 (SEGG)
unnamed: JP16.15 (D1), U13.9 (D6)
unnamed: JP16.16 (D2), U13.8 (D5)
unnamed: JP16.17 (D3), U13.6 (D4)
unnamed: JP16.9 (D5), U13.5 (D2)
unnamed: JP16.8 (D6), U13.3 (D1)
unnamed: JP16.6 (A), U14.20 (SEGA)
unnamed: JP16.5 (B), U14.17 (SEGB)
unnamed: JP16.27 (C), U14.16 (SEGC)
unnamed: JP16.26 (D), U14.19 (SEGD)
unnamed: JP16.25 (E), U14.21 (SEGE)
unnamed: JP16.7 (F), U14.15 (SEGF)
unnamed: JP16.4 (G), U14.22 (SEGG)
unnamed: JP16.28 (DP), U14.23 (DP)
unnamed: JP16.22 (D1), U14.9 (D6)
unnamed: PRIM_PREC_SELECT.2, R24.1
unnamed: JP16.10 (D4), R22.1, U13.4 (D3)
unnamed: JP16.24 (D3), U14.6 (D4)
unnamed: JP16.23 (D2), U14.8 (D5)
OCD_CM: C20.1, D7.+, R19.2, R20.2, TP1.2, U10.3 (IN-)
OCD_CMP: OCD_EN.1, TP1.4, U10.7 (OUT)
OCD_DETECT: JP5.11 (8), U11.6 (/Q)
OCD_LIMIT: TP1.3, U4.1 (VOUT), U10.2 (IN+)
PRIMARY: TP2.3, U6.7 (Q), U8.13 (I1), U9.13 (I), U11.11 (CLK)
RAW: JP5.24 (RAW)
SCL: I2C.1, JP5.A5, R6.2, U4.5 (SCL)
SDA: I2C.2, JP5.A4, R5.2, U4.4 (SDA)
TEST: JP5.19 (A2), R2.1, TEST.1
TRIG: JP5.20 (A3), R1.1, TRIG.1
UVLO: TP2.4, U12.1 (/RESET), UVLO_EN.2
VCC: C1.1, C5.1, C6.1, C12.1, C18.2, C21.1, C22.1, C23.1, C27.2, C28.2, C29.1, C30.2, C31.1, C32.2, I2C.4, JP5.21 (VCC), L2.P$2 (2), MODE.2, MSTR.2, NEOPIXEL.1, R5.1, R6.1, R9.2, R13.2, R21.2, R29.2, TEST.2, TP3.4, TRIG.2, U2.5 (VCC), U3.4 (FB), U4.3 (VDD), U4.6 (VREF), U6.1 (VCC+), U8.14 (VCC), U9.14 (VCC), U10.8 (VCC+), U11.2 (D), U11.4 (/PRE), U11.14 (VCC), U13.12 (/RESET), U13.18 (VDD), U14.12 (/RESET), U14.18 (VDD)

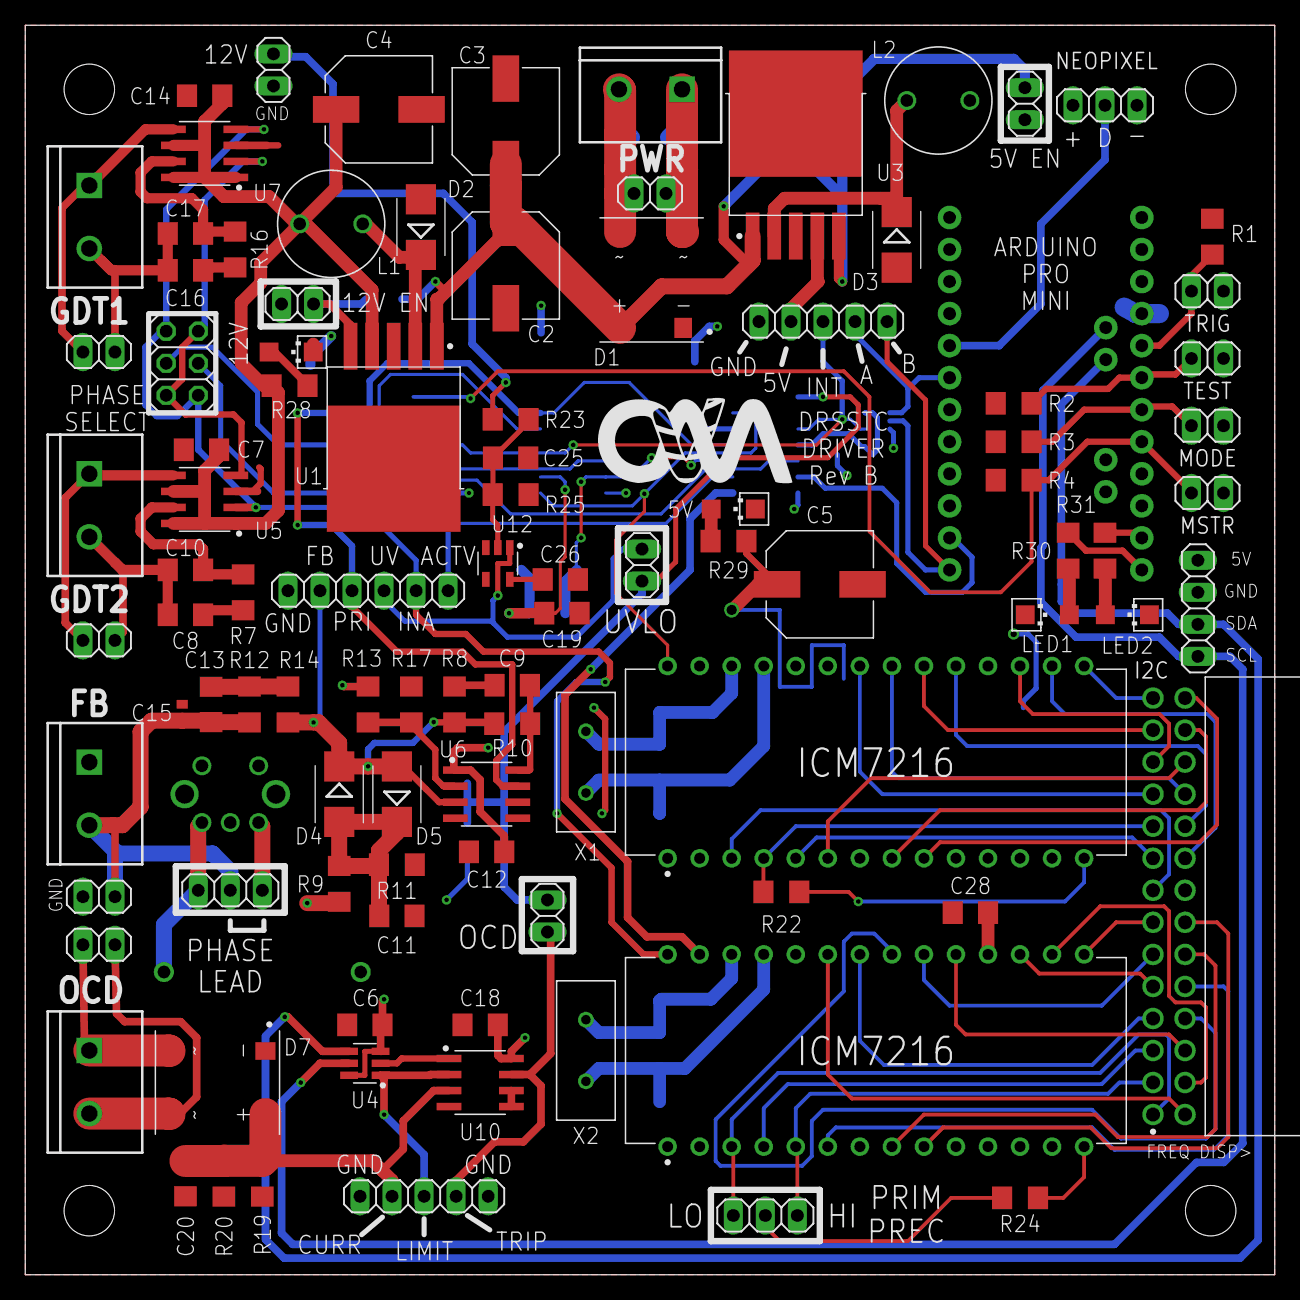
[picture p52: board drsstc.brd from above]

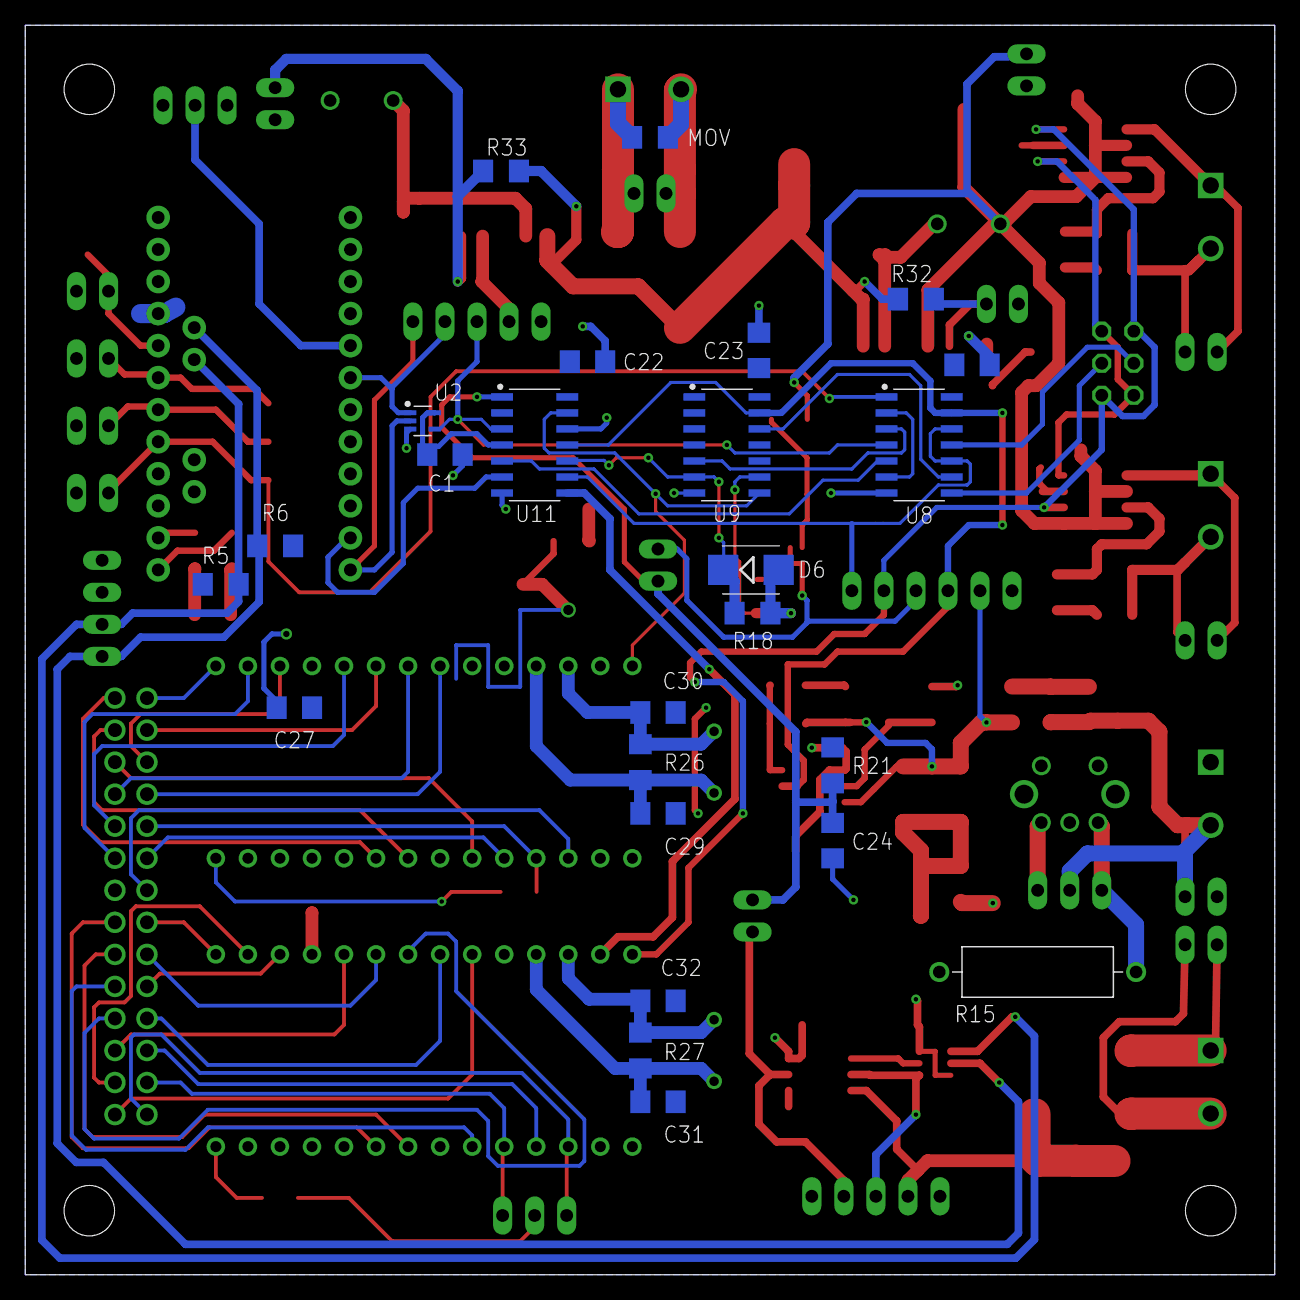
[picture p53: board drsstc.brd from below]

Board: 2 copper layers, 99.1 x 99.1 mm, 125 parts (25 on the bottom side), 102 nets.
