iduwhux/drsstc2/switch_board.brd

## EAGLE design switch_board.brd (2019-03-26)

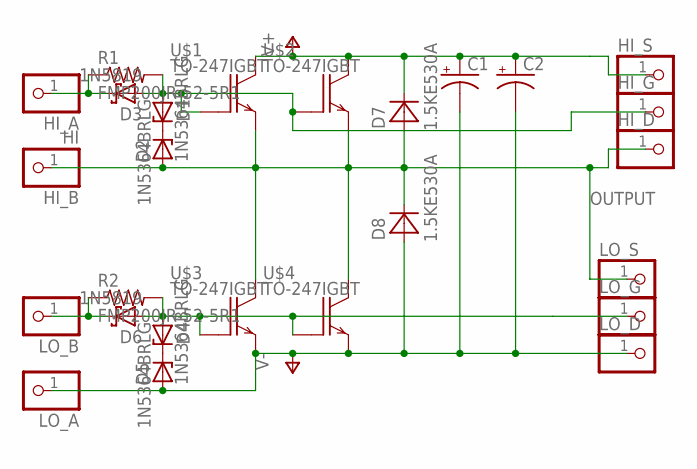
[picture p54: schematic switch_board.sch]

Parts:
C1, C2: CPOL-USTAP5-45; TAP5-45
D1, D2, D4, D5: 1N5364BRLG; DIOAD1576W109L863D349B
D3, D6: 1N5819; DIOAD1138W86L470D235B
D7, D8: 1.5KE530A; DIOAD1631W107L835D505B
HI_A: PINHD-1X1; 1X01
HI_B: HI; 1X01
HI_D: PINHD-1X1; 1X01
HI_G: PINHD-1X1; 1X01
HI_S: PINHD-1X1; 1X01
LO_A: PINHD-1X1; 1X01
LO_B: PINHD-1X1; 1X01
LO_D: PINHD-1X1; 1X01
LO_G: PINHD-1X1; 1X01
LO_S: PINHD-1X1; 1X01
R1, R2: FMP200JR-52-5R1; RESAD1260W55L900D390B
U$1, U$2, U$3, U$4: TO-247IGBT; TO-247

Connections:
unnamed: D1.2 (A), D3.2 (A), HI_G.1, R1.2, U$1.G, U$2.G
unnamed: D1.1 (C), D2.1 (C)
unnamed: D3.1 (C), HI_A.1, R1.1
unnamed: D4.2 (A), D6.2 (A), LO_G.1, R2.2, U$3.G, U$4.G
unnamed: D4.1 (C), D5.1 (C)
unnamed: D6.1 (C), LO_B.1, R2.1
OUTPUT: D2.2 (A), D7.2 (A), D8.1 (C), HI_B.1, HI_D.1, LO_S.1, U$1.E, U$2.E, U$3.C, U$4.C
V+: C1.+, C2.+, D7.1 (C), HI_S.1, U$1.C, U$2.C
V-: C1.-, C2.-, D5.2 (A), D8.2 (A), LO_A.1, LO_D.1, U$3.E, U$4.E

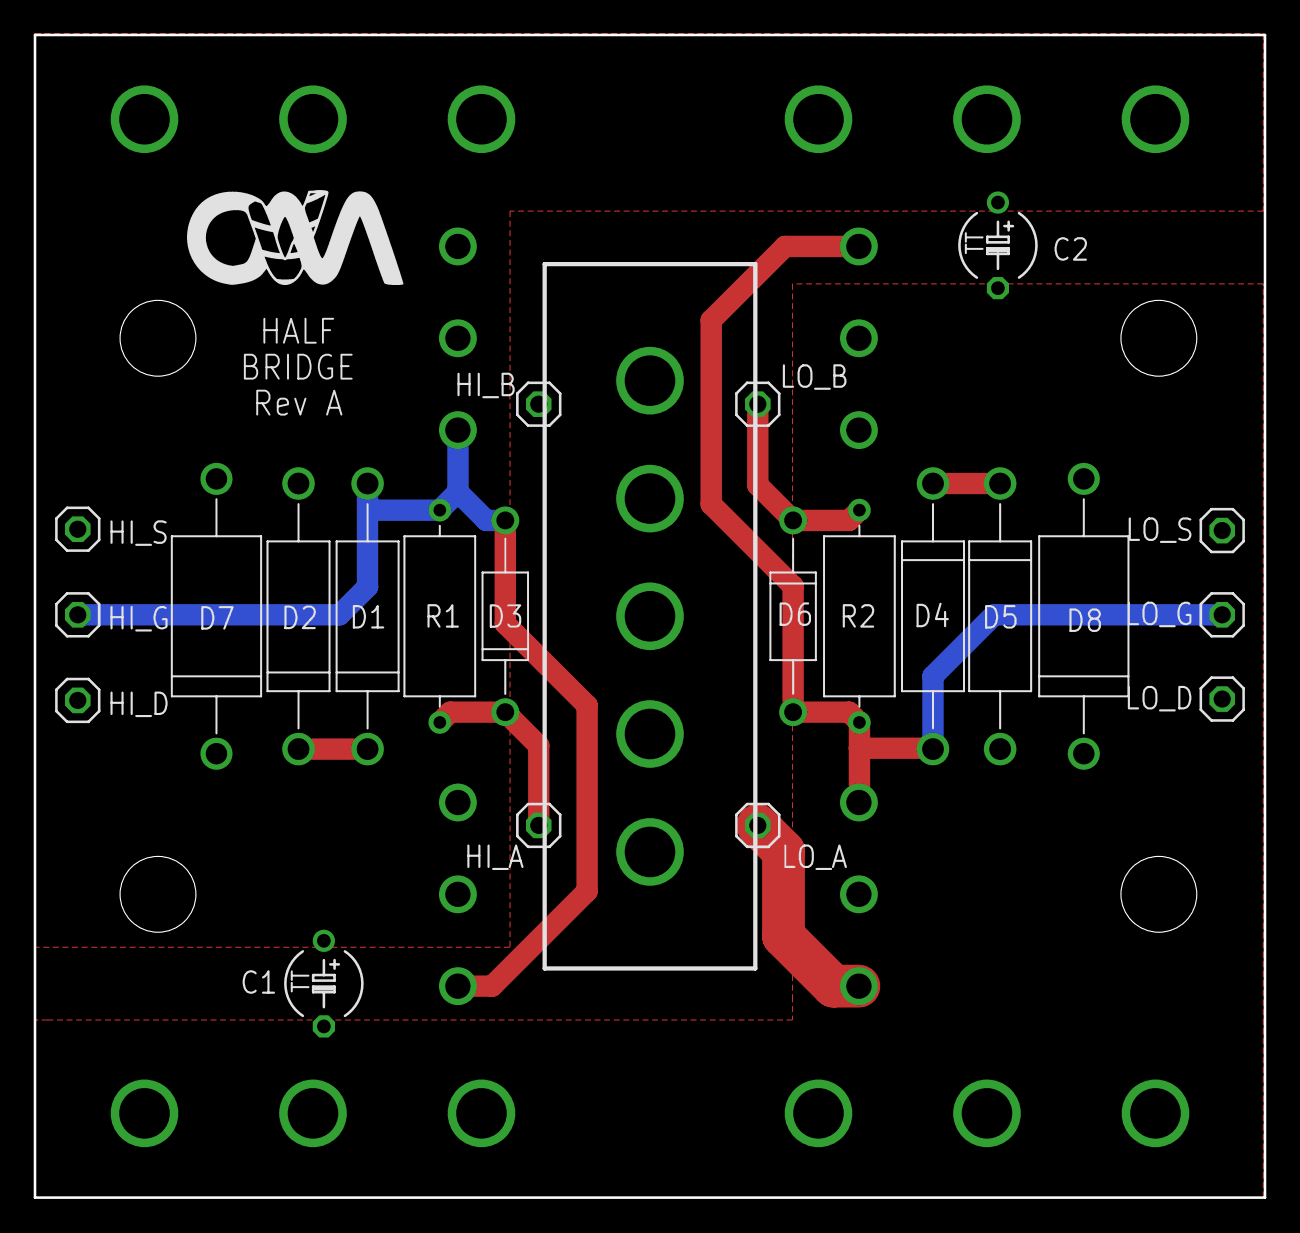
[picture p55: board switch_board.brd from above]

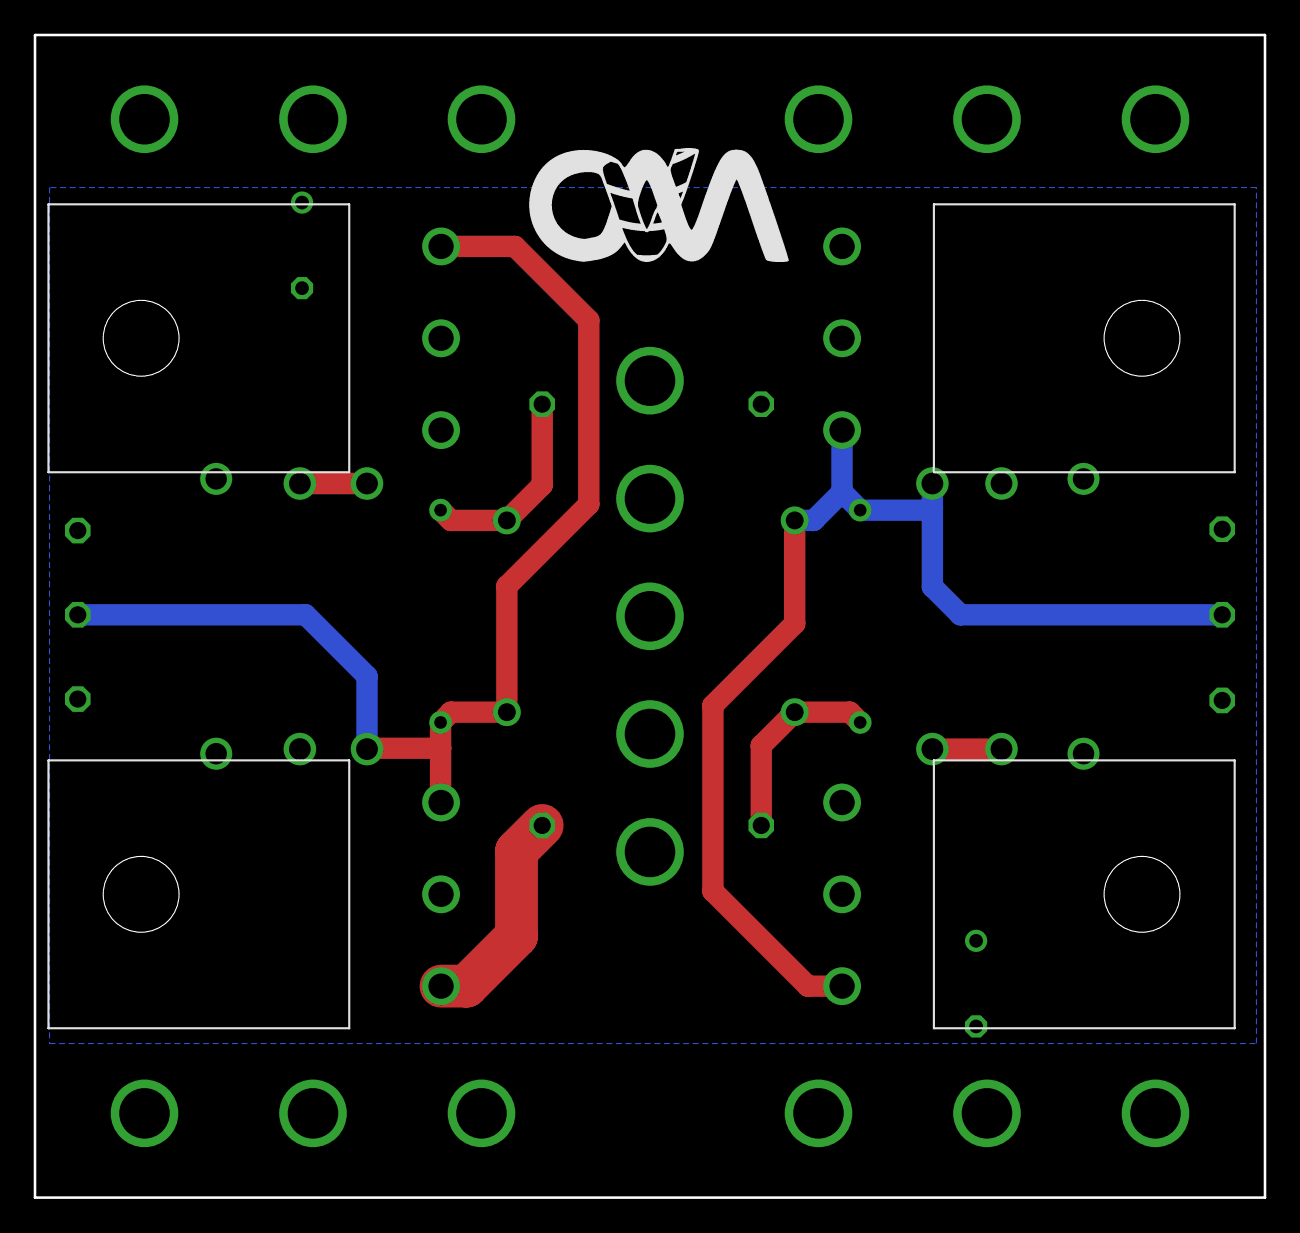
[picture p56: board switch_board.brd from below]

Board: 2 copper layers, 73.0 x 69.0 mm, 26 parts (4 on the bottom side), 9 nets.
