iduwhux/drsstc2/led_panel.brd

## EAGLE design led_panel.brd (2018-12-22)

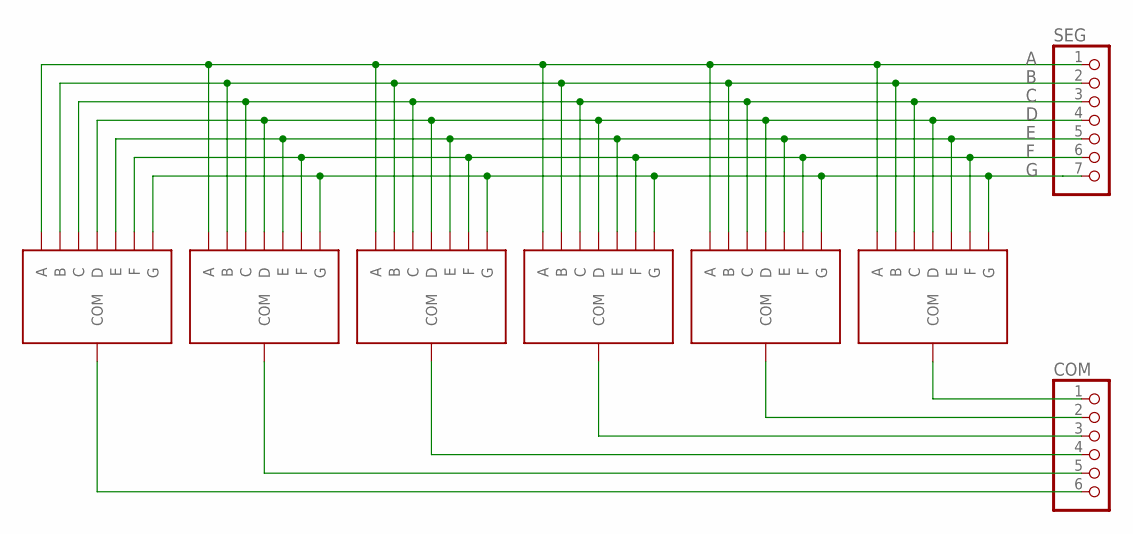
[picture p57: schematic led_panel.sch]

Parts:
COM: PINHD-1X6; 1X06
SEG: PINHD-1X7; 1X07
U$1, U$2, U$3, U$4, U$5, U$6: 7SEGMENTLED

Connections:
A: SEG.1, U$1.P$4 (A), U$2.P$4 (A), U$3.P$4 (A), U$4.P$4 (A), U$5.P$4 (A), U$6.P$4 (A)
B: SEG.2, U$1.P$5 (B), U$2.P$5 (B), U$3.P$5 (B), U$4.P$5 (B), U$5.P$5 (B), U$6.P$5 (B)
C: SEG.3, U$1.P$9 (C), U$2.P$9 (C), U$3.P$9 (C), U$4.P$9 (C), U$5.P$9 (C), U$6.P$9 (C)
D: SEG.4, U$1.P$7 (D), U$2.P$7 (D), U$3.P$7 (D), U$4.P$7 (D), U$5.P$7 (D), U$6.P$7 (D)
E: SEG.5, U$1.P$6 (E), U$2.P$6 (E), U$3.P$6 (E), U$4.P$6 (E), U$5.P$6 (E), U$6.P$6 (E)
F: SEG.6, U$1.P$2 (F), U$2.P$2 (F), U$3.P$2 (F), U$4.P$2 (F), U$5.P$2 (F), U$6.P$2 (F)
G: SEG.7, U$1.P$1 (G), U$2.P$1 (G), U$3.P$1 (G), U$4.P$1 (G), U$5.P$1 (G), U$6.P$1 (G)
unnamed: COM.6, U$1.P$3 (COM), U$1.P$8 (COM), U$1.P$10 (COM)
unnamed: COM.5, U$2.P$3 (COM), U$2.P$8 (COM), U$2.P$10 (COM)
unnamed: COM.4, U$3.P$3 (COM), U$3.P$8 (COM), U$3.P$10 (COM)
unnamed: COM.3, U$4.P$3 (COM), U$4.P$8 (COM), U$4.P$10 (COM)
unnamed: COM.2, U$5.P$3 (COM), U$5.P$8 (COM), U$5.P$10 (COM)
unnamed: COM.1, U$6.P$3 (COM), U$6.P$8 (COM), U$6.P$10 (COM)

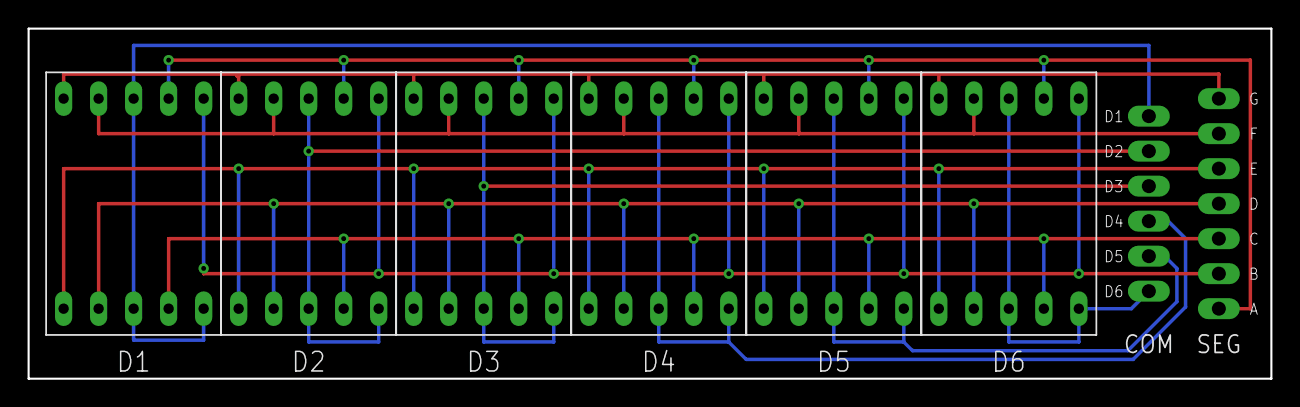
[picture p58: board led_panel.brd from above]

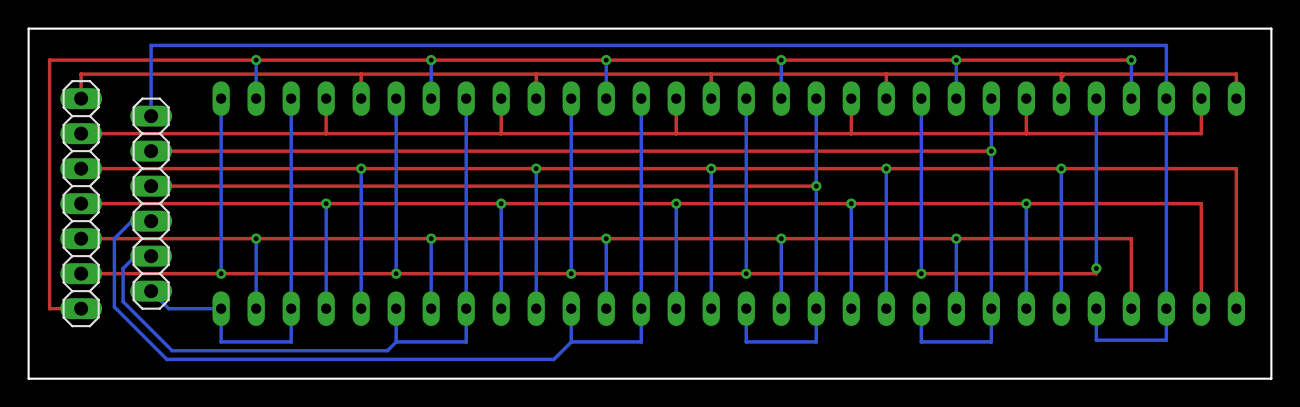
[picture p59: board led_panel.brd from below]

Board: 2 copper layers, 90.2 x 25.4 mm, 8 parts (2 on the bottom side), 13 nets.
