iduwhux/drsstc2/logic_board.brd

## EAGLE design logic_board.brd (2018-12-22)

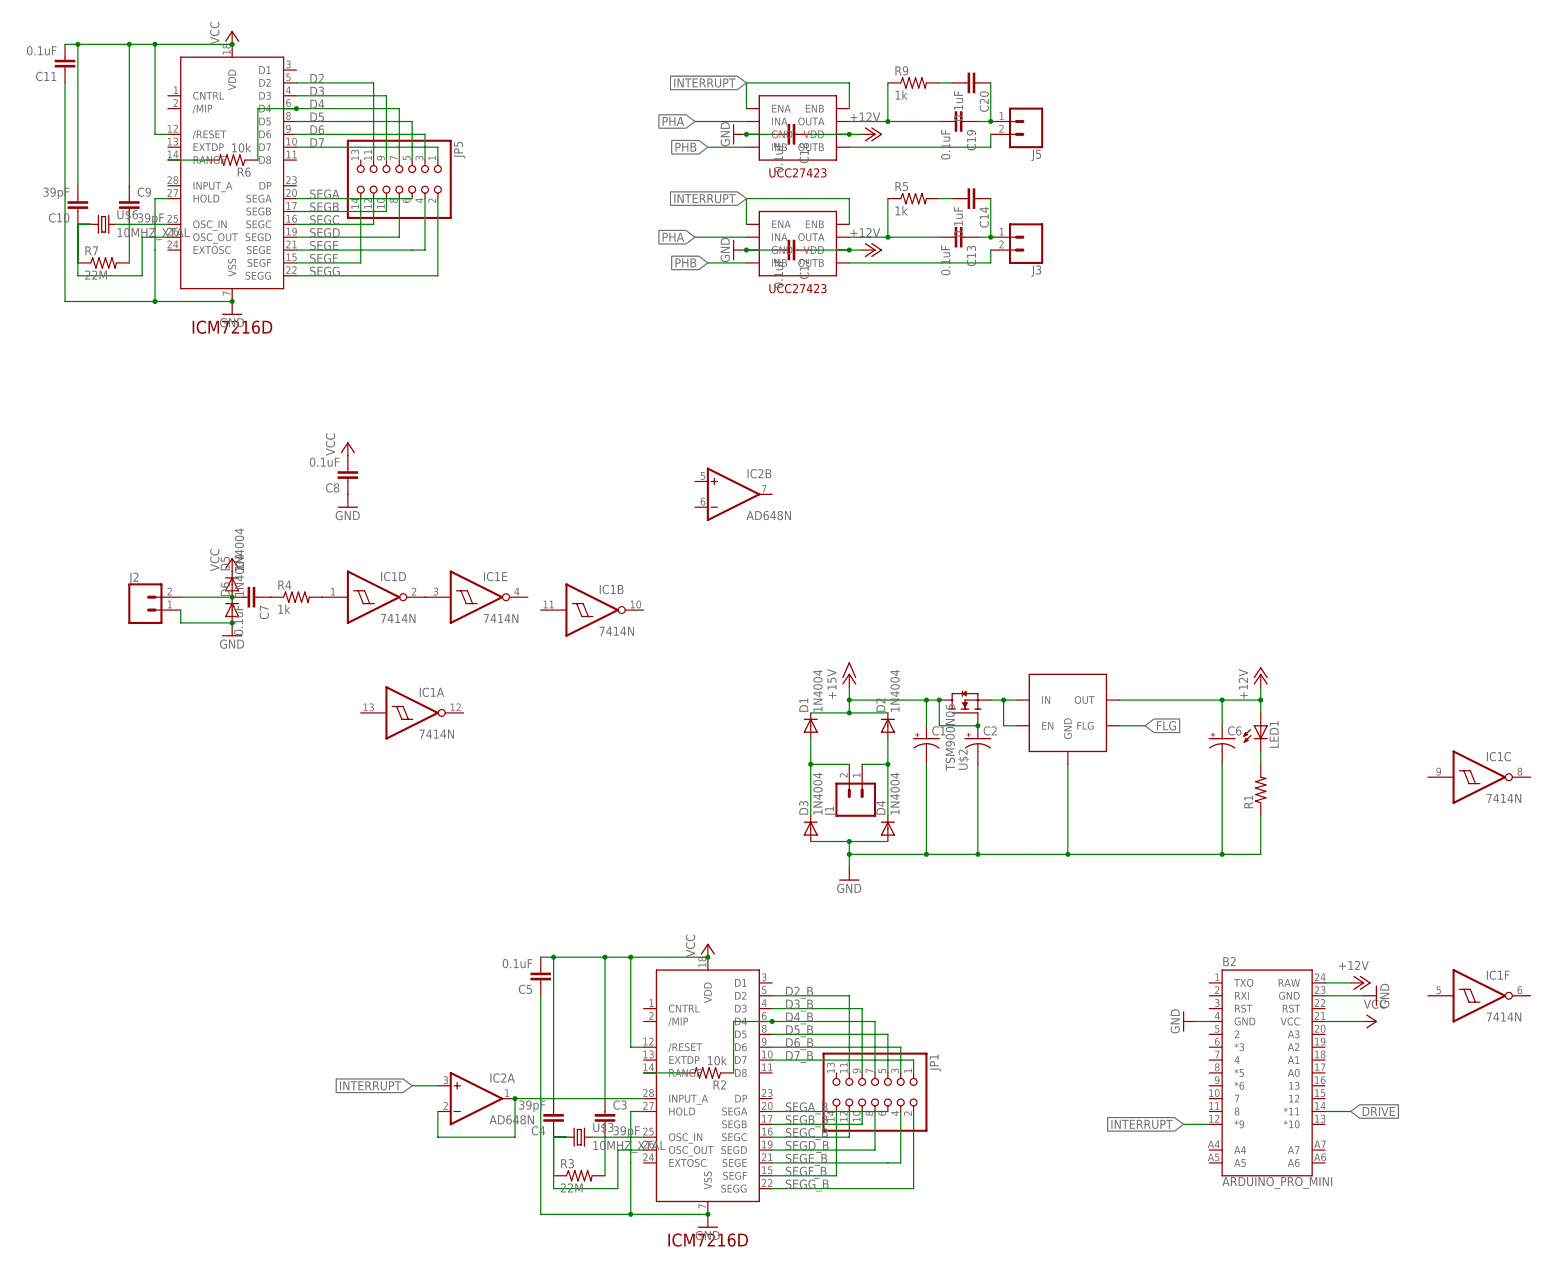
[picture p60: schematic logic_board.sch]

Parts:
B2: ARDUINO_PRO_MINI
C1, C2, C6: CPOL-USE7.5-16; E7,5-16
C3, C4, C9, C10: 39pF; C050-030X075
C5, C7, C8, C11, C12, C13, C14, C18, C19, C20: 0.1uF; C050-030X075
D1, D2, D3, D4, D5, D6: 1N4004; DO41-10
IC1: 7414N; DIL14
IC2: AD648N; DIL08
J1, J2, J3, J5: CONN_025MM; SCREWTERMINAL-5MM-2
JP1, JP5: PINHD-2X7; 2X07
LED1: LED5MM
R1: R-US_0204/7; 0204/7
R2, R6: 10k; 0204/7
R3, R7: 22M; 0204/7
R4, R5, R9: 1k; 0204/7
U$1, U$5: ICM7216D; DIP1524W55P254L3740H635Q28B
U$2: TSM900N06; TO-251S
U$3, U$6: 10MHZ_XTAL; XTAL
U$4: MIC29301; TO-220
U$7, U$9: UCC27423; DIP762W53P254L959H508Q8B

Connections:
+12V: B2.24 (RAW), C6.+, C12.1, C18.1, LED1.A, U$4.P$4 (OUT), U$7.6 (VDD), U$9.6 (VDD)
+15V: C1.+, C2.+, D1.C, D2.C, U$2.P$1 (G), U$2.P$2 (D)
D2: JP5.11, U$5.5 (D2)
D2_B: JP1.11, U$1.5 (D2)
D3: JP5.9, U$5.4 (D3)
D3_B: JP1.9, U$1.4 (D3)
D4: JP5.7, R6.1, U$5.6 (D4)
D4_B: JP1.7, R2.1, U$1.6 (D4)
D5: JP5.5, U$5.8 (D5)
D5_B: JP1.5, U$1.8 (D5)
D6: JP5.3, U$5.9 (D6)
D6_B: JP1.3, U$1.9 (D6)
D7: JP5.1, U$5.10 (D7)
D7_B: JP1.1, U$1.10 (D7)
DRIVE: B2.14 (*11)
FLG: U$4.P$5 (FLG)
GND: B2.4 (GND), B2.23 (GND), C1.-, C2.-, C5.1, C6.-, C8.1, C11.1, C12.2, C18.2, D3.A, D4.A, D6.A, IC1.7 (GND), J2.1, R1.1, U$1.7 (VSS), U$1.27 (HOLD), U$4.P$3 (GND), U$5.7 (VSS), U$5.27 (HOLD), U$7.3 (GND), U$9.3 (GND)
INTERRUPT: B2.12 (*9), IC2.3 (+IN), U$7.1 (ENA), U$7.8 (ENB), U$9.1 (ENA), U$9.8 (ENB)
unnamed: D1.A, D3.C, J1.2
unnamed: D2.A, D4.C, J1.1
unnamed: U$2.P$3 (S), U$4.P$1 (EN), U$4.P$2 (IN)
unnamed: LED1.K (C), R1.2
unnamed: C3.2, R3.2, U$1.25 (OSC_IN), U$3.P$2 (2)
unnamed: C4.1, R3.1, U$1.26 (OSC_OUT), U$3.P$1 (1)
unnamed: C7.2, D5.A, D6.C, J2.2
unnamed: C13.1, C14.1, J3.1
unnamed: C7.1, R4.1
unnamed: R2.2, U$1.14 (RANGE)
unnamed: R6.2, U$5.14 (RANGE)
unnamed: C9.2, R7.2, U$5.25 (OSC_IN), U$6.P$2 (2)
unnamed: C10.1, R7.1, U$5.26 (OSC_OUT), U$6.P$1 (1)
unnamed: IC1.1 (I), R4.2
unnamed: IC1.2 (O), IC1.3 (I)
unnamed: C14.2, R5.2
unnamed: C13.2, R5.1, U$7.7 (OUTA)
unnamed: J3.2, U$7.5 (OUTB)
unnamed: IC2.1 (OUT), IC2.2 (-IN), U$1.28 (INPUT_A)
unnamed: C19.1, C20.1, J5.1
unnamed: C20.2, R9.2
unnamed: C19.2, R9.1, U$9.7 (OUTA)
unnamed: J5.2, U$9.5 (OUTB)
PHA: U$7.2 (INA), U$9.2 (INA)
PHB: U$7.4 (INB), U$9.4 (INB)
SEGA: JP5.6, U$5.20 (SEGA)
SEGA_B: JP1.6, U$1.20 (SEGA)
SEGB: JP5.10, U$5.17 (SEGB)
SEGB_B: JP1.10, U$1.17 (SEGB)
SEGC: JP5.12, U$5.16 (SEGC)
SEGC_B: JP1.12, U$1.16 (SEGC)
SEGD: JP5.8, U$5.19 (SEGD)
SEGD_B: JP1.8, U$1.19 (SEGD)
SEGE: JP5.4, U$5.21 (SEGE)
SEGE_B: JP1.4, U$1.21 (SEGE)
SEGF: JP5.14, U$5.15 (SEGF)
SEGF_B: JP1.14, U$1.15 (SEGF)
SEGG: JP5.2, U$5.22 (SEGG)
SEGG_B: JP1.2, U$1.22 (SEGG)
V+: IC2.8 (V+)
V-: IC2.4 (V-)
VCC: B2.21 (VCC), C3.1, C4.2, C5.2, C8.2, C9.1, C10.2, C11.2, D5.C, IC1.14 (VCC), U$1.12 (/RESET), U$1.18 (VDD), U$5.12 (/RESET), U$5.18 (VDD)

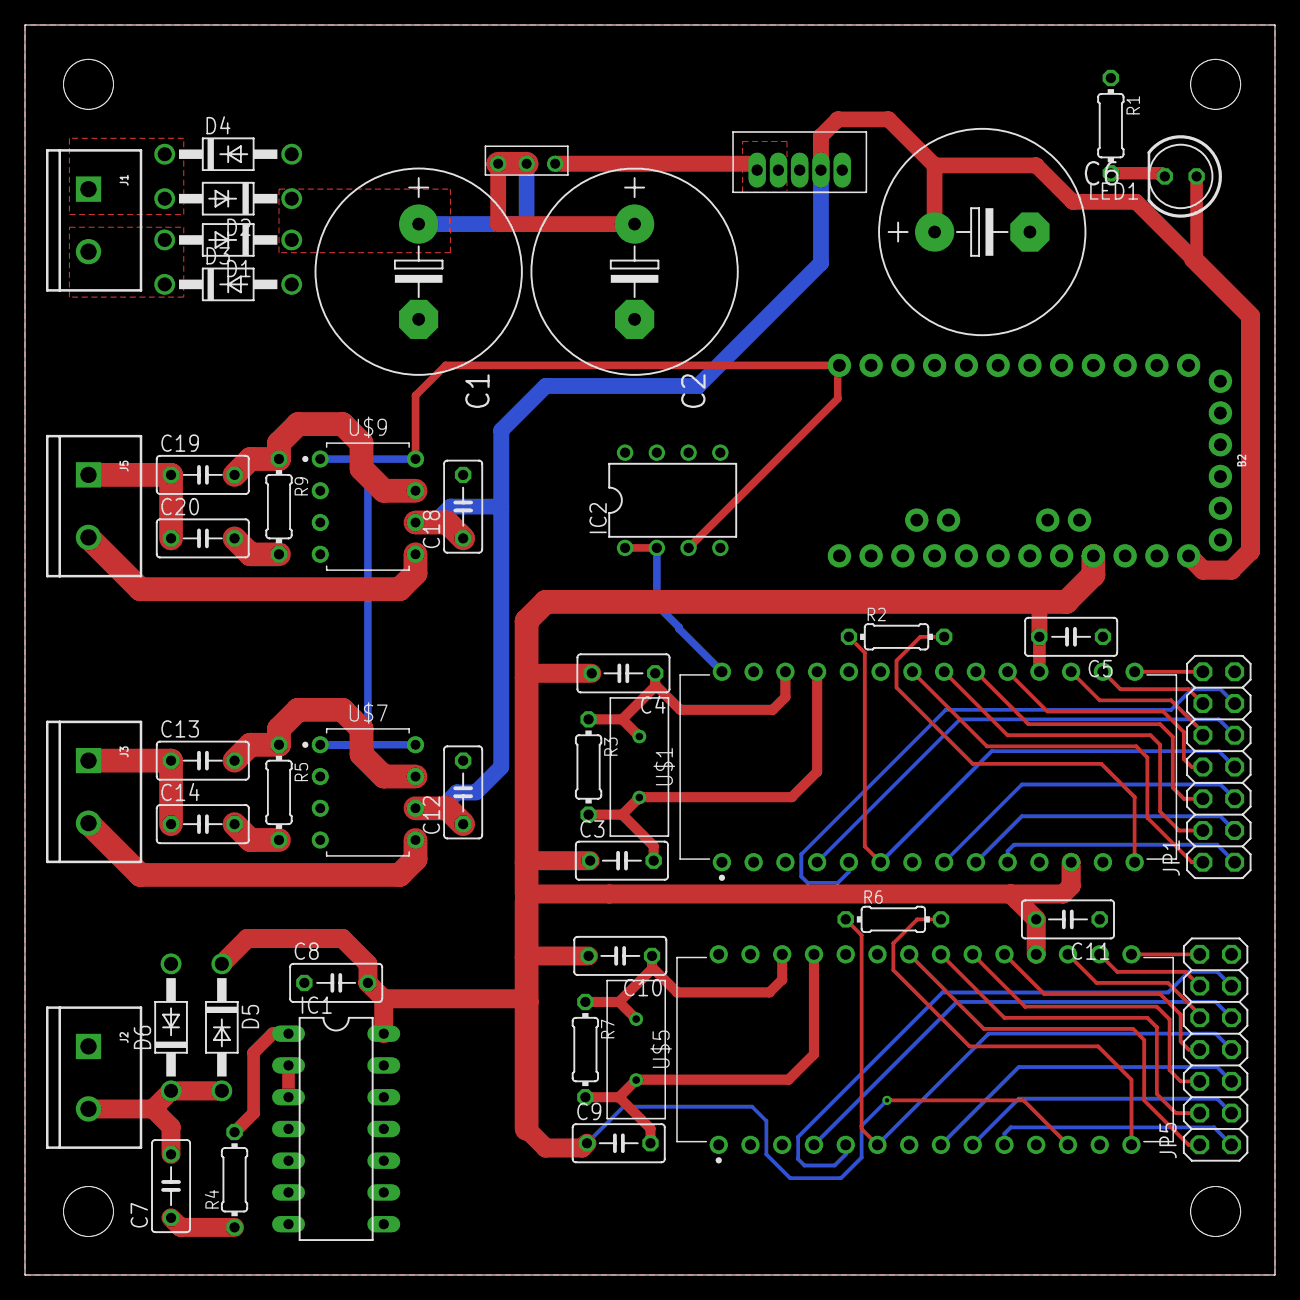
[picture p61: board logic_board.brd from above]

Board: 2 copper layers, 100.0 x 100.0 mm, 49 parts (0 on the bottom side), 56 nets.
