iduwhux/drsstc2/firmware/drsstc_firmware/pin_definitions.h

#pragma once

// Pin definitions

#define NEOPIXEL    2   // Output data pin for neopixels
#define PWM_1       9   // Labeled 'B' on board, connected to Timer1
#define PWM_2       3   // Labeled 'A' on board, connected to Timer2
#define OCD_DETECT  8   // Input for overcurrent detection
#define LED1       10   // Status LED 1 output
#define LED2       11   // Status LED 2 output
#define MSTR_EN    A0   // Master switch input
#define MODE_IN    A1   // Mode switch input
#define TEST_IN    A2   // Test switch input
#define TRIG_IN    A3   // Trigger switch input
