iduwhux/drsstc2/firmware/drsstc_firmware/BachInvention.cpp

#include "MIDIPlayer.h"

// converted from invent1.mid - 1439 bytes total
extern const byte BACH_INVENTION[] PROGMEM = 
{
      0x01,0xf0,0x2a,0x4a,0xca, //      0 BEGIN PROGRAM (240 ticks/beat, tempo = 697674 us/beat)
                0xbc,0xbc,0x05, //     60 T1 ON, NOTE  60 VOLUME  5
                0xbc,0xbe,0x05, //     60 T1 ON, NOTE  62 VOLUME  5
                0xbc,0xc0,0x05, //     60 T1 ON, NOTE  64 VOLUME  5
                0xbc,0xc1,0x05, //     60 T1 ON, NOTE  65 VOLUME  5
                0xbc,0xbe,0x05, //     60 T1 ON, NOTE  62 VOLUME  5
                0xbc,0xc0,0x05, //     60 T1 ON, NOTE  64 VOLUME  5
                0xbc,0xbc,0x05, //     60 T1 ON, NOTE  60 VOLUME  5
                0xbc,0xc3,0x05, //     60 T1 ON, NOTE  67 VOLUME  5
                0xbc,0x30,0x05, //     60 T2 ON, NOTE  48 VOLUME  5
                0xbc,0xc8,0x05, //     60 T1 ON, NOTE  72 VOLUME  5
                0x80,0x32,0x05, //      0 T2 ON, NOTE  50 VOLUME  5
                0xbc,0x34,0x05, //     60 T2 ON, NOTE  52 VOLUME  5
                0xbc,0xc7,0x05, //     60 T1 ON, NOTE  71 VOLUME  5
                0x80,0x35,0x05, //      0 T2 ON, NOTE  53 VOLUME  5
                0x9e,0xc5,0x05, //     30 T1 ON, NOTE  69 VOLUME  5
                0x9e,0xc7,0x05, //     30 T1 ON, NOTE  71 VOLUME  5
                0x80,0x32,0x05, //      0 T2 ON, NOTE  50 VOLUME  5
                0xbc,0xc8,0x05, //     60 T1 ON, NOTE  72 VOLUME  5
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
                0x80,0x2b,0x05, //      0 T2 ON, NOTE  43 VOLUME  5
                0xbc,0xc7,0x05, //     60 T1 ON, NOTE  71 VOLUME  5
                0xbc,0xc8,0x05, //     60 T1 ON, NOTE  72 VOLUME  5
                0x80,0x43,0x05, //      0 T2 ON, NOTE  67 VOLUME  5
                0x07,0xc0,0x01, //    960 BOTH OFF
                     0x80,0x05  //      0 END PROGRAM
};
