iduwhux/drsstc2/firmware/drsstc_firmware/MarriageOfFigaro.cpp

#include "MIDIPlayer.h"

// converted from mfig.mid - 6540 bytes total
extern const byte MARRIAGE_OF_FIGARO[] PROGMEM = 
{
           0xb0,0x0e,0x27,0x87, //      0 BEGIN PROGRAM (48 ticks/beat, tempo = 234375 us/beat)
                0x80,0xb2,0x08, //      0 T1 ON, NOTE  50 VOLUME  8
                0x98,0xb1,0x08, //     24 T1 ON, NOTE  49 VOLUME  8
                0x98,0xb2,0x08, //     24 T1 ON, NOTE  50 VOLUME  8
                0x98,0xb1,0x08, //     24 T1 ON, NOTE  49 VOLUME  8
                0x98,0xb2,0x08, //     24 T1 ON, NOTE  50 VOLUME  8
                     0xb0,0x01, //     48 BOTH OFF
                0xb0,0xb2,0x08, //     48 T1 ON, NOTE  50 VOLUME  8
                0x98,0xb1,0x08, //     24 T1 ON, NOTE  49 VOLUME  8
                0x98,0xb2,0x08, //     24 T1 ON, NOTE  50 VOLUME  8
                0x98,0xb4,0x08, //     24 T1 ON, NOTE  52 VOLUME  8
                0x98,0xb6,0x08, //     24 T1 ON, NOTE  54 VOLUME  8
                0x98,0xb4,0x08, //     24 T1 ON, NOTE  52 VOLUME  8
                0x98,0xb6,0x08, //     24 T1 ON, NOTE  54 VOLUME  8
                0x98,0xb7,0x08, //     24 T1 ON, NOTE  55 VOLUME  8
                0x98,0xb9,0x08, //     24 T1 ON, NOTE  57 VOLUME  8
                0x98,0xb8,0x08, //     24 T1 ON, NOTE  56 VOLUME  8
                0x98,0xb9,0x08, //     24 T1 ON, NOTE  57 VOLUME  8
                0x98,0xb8,0x08, //     24 T1 ON, NOTE  56 VOLUME  8
                0x98,0xb9,0x08, //     24 T1 ON, NOTE  57 VOLUME  8
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
                0x98,0xb7,0x08, //     24 T1 ON, NOTE  55 VOLUME  8
                0x98,0xb2,0x08, //     24 T1 ON, NOTE  50 VOLUME  8
                0x98,0xbd,0x08, //     24 T1 ON, NOTE  61 VOLUME  8
                0x98,0xbb,0x08, //     24 T1 ON, NOTE  59 VOLUME  8
                0x98,0xb9,0x08, //     24 T1 ON, NOTE  57 VOLUME  8
                0x98,0xb2,0x08, //     24 T1 ON, NOTE  50 VOLUME  8
                0x98,0xb9,0x08, //     24 T1 ON, NOTE  57 VOLUME  8
                0x98,0xbb,0x08, //     24 T1 ON, NOTE  59 VOLUME  8
                0x98,0xbd,0x08, //     24 T1 ON, NOTE  61 VOLUME  8
                0x98,0xb2,0x08, //     24 T1 ON, NOTE  50 VOLUME  8
                0x98,0xbd,0x08, //     24 T1 ON, NOTE  61 VOLUME  8
                0x98,0xbe,0x08, //     24 T1 ON, NOTE  62 VOLUME  8
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
