iduwhux/drsstc2/firmware/drsstc_firmware/SugarPlumFairy.cpp

#include "MIDIPlayer.h"

// converted from tchaikovksy_sugar_plum.mid - 2324 bytes total
extern const byte SUGAR_PLUM_FAIRY[] PROGMEM = 
{
      0x02,0x80,0x1e,0x42,0xa0, //      0 BEGIN PROGRAM (256 ticks/beat, tempo = 500000 us/beat)
                0x80,0xb2,0x04, //      0 T1 ON, NOTE  50 VOLUME  4
                     0xff,0x01, //    127 BOTH OFF
           0x01,0x81,0xbe,0x04, //    129 T1 ON, NOTE  62 VOLUME  4
                0x80,0x39,0x04, //      0 T2 ON, NOTE  57 VOLUME  4
                     0xff,0x01, //    127 BOTH OFF
           0x01,0x81,0xb2,0x04, //    129 T1 ON, NOTE  50 VOLUME  4
                     0xff,0x01, //    127 BOTH OFF
           0x01,0x81,0xc0,0x04, //    129 T1 ON, NOTE  64 VOLUME  4
                0x80,0x3a,0x04, //      0 T2 ON, NOTE  58 VOLUME  4
                     0xff,0x01, //    127 BOTH OFF
           0x01,0x81,0xb2,0x04, //    129 T1 ON, NOTE  50 VOLUME  4
                     0xff,0x01, //    127 BOTH OFF
           0x01,0x81,0xc1,0x04, //    129 T1 ON, NOTE  65 VOLUME  4
                0x80,0x3b,0x04, //      0 T2 ON, NOTE  59 VOLUME  4
                     0xff,0x01, //    127 BOTH OFF
           0x01,0x81,0xb2,0x04, //    129 T1 ON, NOTE  50 VOLUME  4
                     0xff,0x01, //    127 BOTH OFF
           0x01,0x81,0xbd,0x04, //    129 T1 ON, NOTE  61 VOLUME  4
                0x80,0x3a,0x04, //      0 T2 ON, NOTE  58 VOLUME  4
                     0xff,0x01, //    127 BOTH OFF
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
                     0xff,0x01, //    127 BOTH OFF
                0xa2,0xc5,0x07, //     34 T1 ON, NOTE  69 VOLUME  7
                0xa0,0xc9,0x09, //     32 T1 ON, NOTE  73 VOLUME  9
                0x94,0xcc,0x09, //     20 T1 ON, NOTE  76 VOLUME  9
                0xab,0xd1,0x09, //     43 T1 ON, NOTE  81 VOLUME  9
                0x80,0x37,0x0a, //      0 T2 ON, NOTE  55 VOLUME 10
                0xe5,0xb9,0x0a, //    101 T1 ON, NOTE  57 VOLUME 10
                     0x9a,0x01, //     26 BOTH OFF
           0x01,0x81,0xd6,0x09, //    129 T1 ON, NOTE  86 VOLUME  9
                0x80,0x39,0x0a, //      0 T2 ON, NOTE  57 VOLUME 10
                     0xff,0x01, //    127 BOTH OFF
                     0x80,0x05  //      0 END PROGRAM
};
