iduwhux/drsstc2/firmware/drsstc_firmware/WilliamTell.cpp

#include "MIDIPlayer.h"

// converted from rossini_overture_wtellrecorders.mid - 5329 bytes total
extern const byte WILLIAM_TELL[] PROGMEM = 
{
      0x07,0xc0,0x24,0x4f,0xc0, //      0 BEGIN PROGRAM (960 ticks/beat, tempo = 600000 us/beat)
                0x80,0xd6,0x06, //      0 T1 ON, NOTE  86 VOLUME  6
                0x07,0xc0,0x01, //    960 BOTH OFF
           0x03,0xe0,0xd6,0x06, //    480 T1 ON, NOTE  86 VOLUME  6
           0x03,0xe0,0xd6,0x07, //    480 T1 ON, NOTE  86 VOLUME  7
                0x07,0xc0,0x01, //    960 BOTH OFF
           0x03,0xe0,0xd6,0x07, //    480 T1 ON, NOTE  86 VOLUME  7
           0x07,0xc0,0xd3,0x07, //    960 T1 ON, NOTE  83 VOLUME  7
           0x03,0xe0,0xcf,0x06, //    480 T1 ON, NOTE  79 VOLUME  6
           0x03,0xe0,0xd3,0x08, //    480 T1 ON, NOTE  83 VOLUME  8
           0x03,0xe0,0xd6,0x08, //    480 T1 ON, NOTE  86 VOLUME  8
           0x03,0xe0,0xd3,0x07, //    480 T1 ON, NOTE  83 VOLUME  7
           0x03,0xe0,0xd6,0x08, //    480 T1 ON, NOTE  86 VOLUME  8
           0x03,0xe0,0xdb,0x08, //    480 T1 ON, NOTE  91 VOLUME  8
           0x03,0xe0,0xd6,0x06, //    480 T1 ON, NOTE  86 VOLUME  6
                0x80,0x53,0x07, //      0 T2 ON, NOTE  83 VOLUME  7
           0x03,0xe0,0xd3,0x06, //    480 T1 ON, NOTE  83 VOLUME  6
                0x80,0x4f,0x06, //      0 T2 ON, NOTE  79 VOLUME  6
                0x03,0xe0,0x01, //    480 BOTH OFF
           0x03,0xe0,0xd3,0x08, //    480 T1 ON, NOTE  83 VOLUME  8
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
           0x03,0xe0,0xe7,0x0a, //    480 T1 ON, NOTE 103 VOLUME 10
                0x80,0x4f,0x0a, //      0 T2 ON, NOTE  79 VOLUME 10
                0x07,0xc0,0x01, //    960 BOTH OFF
           0x03,0xe0,0xdb,0x0a, //    480 T1 ON, NOTE  91 VOLUME 10
                0x80,0x56,0x0a, //      0 T2 ON, NOTE  86 VOLUME 10
                0x09,0xb0,0x01, //   1200 BOTH OFF
           0x07,0xc0,0xdb,0x08, //    960 T1 ON, NOTE  91 VOLUME  8
                0x80,0x53,0x09, //      0 T2 ON, NOTE  83 VOLUME  9
                0x07,0xc0,0x01, //    960 BOTH OFF
           0x05,0xd0,0xcf,0x08, //    720 T1 ON, NOTE  79 VOLUME  8
                0x80,0x4f,0x09, //      0 T2 ON, NOTE  79 VOLUME  9
           0x01,0xf0,0xcf,0x09, //    240 T1 ON, NOTE  79 VOLUME  9
                0x80,0x47,0x09, //      0 T2 ON, NOTE  71 VOLUME  9
                0x16,0xc0,0x01, //   2880 BOTH OFF
                     0x80,0x05  //      0 END PROGRAM
};
