iduwhux/drsstc2/firmware/drsstc_firmware/OdeToJoy.cpp

#include "MIDIPlayer.h"

// converted from beethoven_ode_to_joy.mid - 416 bytes total
extern const byte ODE_TO_JOY[] PROGMEM = 
{
      0x07,0xc0,0x1a,0x14,0x9b, //      0 BEGIN PROGRAM (960 ticks/beat, tempo = 428571 us/beat)
                0x80,0xc0,0x07, //      0 T1 ON, NOTE  64 VOLUME  7
                0x80,0x3c,0x07, //      0 T2 ON, NOTE  60 VOLUME  7
           0x07,0xd3,0x37,0x07, //    979 T2 ON, NOTE  55 VOLUME  7
           0x07,0xad,0x41,0x09, //    941 T2 ON, NOTE  65 VOLUME  9
                0x93,0xb7,0x07, //     19 T1 ON, NOTE  55 VOLUME  7
           0x07,0xad,0xc3,0x09, //    941 T1 ON, NOTE  67 VOLUME  9
                0x93,0x30,0x07, //     19 T2 ON, NOTE  48 VOLUME  7
           0x07,0xad,0xc3,0x08, //    941 T1 ON, NOTE  67 VOLUME  8
                0x80,0x37,0x08, //      0 T2 ON, NOTE  55 VOLUME  8
           0x07,0xc0,0x41,0x07, //    960 T2 ON, NOTE  65 VOLUME  7
                0x93,0xb7,0x08, //     19 T1 ON, NOTE  55 VOLUME  8
           0x07,0xad,0xc0,0x08, //    941 T1 ON, NOTE  64 VOLUME  8
                0x93,0x37,0x08, //     19 T2 ON, NOTE  55 VOLUME  8
           0x07,0xad,0x3e,0x07, //    941 T2 ON, NOTE  62 VOLUME  7
                0x93,0xb7,0x08, //     19 T1 ON, NOTE  55 VOLUME  8
           0x07,0xad,0xbc,0x07, //    941 T1 ON, NOTE  60 VOLUME  7
                0x93,0x37,0x08, //     19 T2 ON, NOTE  55 VOLUME  8
           0x07,0xad,0xbc,0x08, //    941 T1 ON, NOTE  60 VOLUME  8
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
           0x03,0xc6,0xbc,0x08, //    454 T1 ON, NOTE  60 VOLUME  8
           0x0e,0x9f,0xb4,0x08, //   1823 T1 ON, NOTE  52 VOLUME  8
                     0xe1,0x01, //     97 BOTH OFF
                     0x80,0x05  //      0 END PROGRAM
};
