iduwhux/drsstc2/(commit log)

2019-03-26 Updating files and .gitignore
    [drsstc.brd]
2019-03-26 Adding RF shield patterns
    [logic_board_rf_shield.dxf, logic_board_rf_shield_alignment.dxf, logic_board_rf_shield_handle.dxf, logic_board_rf_shield_top.dxf]
2019-03-26 Adding switch_board
    [switch_board.brd, switch_board.sch]
2019-03-26 Adding switch housing acrylic laser patterns
    [0 - Floor.dxf, 1 - HS Seat Front.dxf, 10,11 - Left Cap Brace 1 and 2.dxf, 12 - Middle Plane.dxf, 13 - Back Plane 1.dxf, 14 - Back Plane 2.dxf, 15,16,17,18 - Top Brace.dxf, 19 - Right Side.dxf]
2019-03-26 Adding board_test Arduino sketch
2019-03-26 Adding TO-247 step model
    [TO-247 v20.step]
2019-03-26 Adding rev A board orders
2019-03-26 Adding FreqCalcs Excel spreadsheet
    [FreqCals.xlsx]
2019-03-27 Updating DXFs for acrylic with smaller kerf offset
    [0 - Floor.dxf, 1 - HS Seat Front.dxf, 10,11 - Left Cap Brace 1 and 2.dxf, 12 - Middle Plane.dxf, 13 - Back Plane 1.dxf, 14 - Back Plane 2.dxf, 15,16,17,18 - Top Brace.dxf, 19 - Right Side.dxf]
2019-03-31 Updating DRSSTC board to Rev B
    [drsstc.brd, drsstc.sch]
2019-03-31 Updating Rev B board, linking freq counter to driver input signal
    [drsstc.brd, drsstc.sch]
2019-03-31 Updating CVM logo
    [drsstc.brd]
2019-03-31 Moving LightShow.cpp code to LEDRing.cpp
2019-03-31 Continuing firmware cleanup, adding LED rotation support to MIDI binary
2019-04-12 Updating Rev B board with hysteresis feedback fix
    [drsstc.brd, drsstc.sch]
2019-04-14 Rev B board
    [drsstc.brd, drsstc.sch]
2019-04-14 Rev B silkscreen tweak
    [drsstc.brd]
2019-05-31 Adding GDT booster board
    [booster.brd, booster.sch]
2019-05-31 Adding GDT booster CAM job and order to JLC PCB
2019-05-31 Adding airflow cover stuff to laser folder
    [airway_cover_separator.dxf, airway_cover_top.dxf]
2019-05-31 Adding PDF schematics
2019-06-01 Adding laser pattern for acrylic
    [booster.brd, ct_horizontal.dxf, ct_vertical.dxf]
2019-06-07 Adding side panel files for laser
    [side_panel_final.dxf, side_panel_outline.dxf]
2019-06-07 Adding 3D printing STL files for booster and logic board mounts
    [BoosterBoardMount.stl, LogicBoardMount.stl]
2019-06-10 Adding bus bar files
    [bus_bars_mount_bottom.dxf, bus_bars_mount_top.dxf]
2019-06-12 Adding control_box files for laser
    [control_box_bottom.dxf, control_box_front.dxf, control_box_right.dxf, control_box_top.dxf]
2019-06-12 Adding fuse support parts to control box laser
    [control_box_fuse_mount.dxf, control_box_fuse_support.dxf]
2019-06-16 Updating control box laser outline
2019-06-17 Factoring out arduino_midi module
2019-06-20 Updating control box top
    [control_box_top.dxf]
2019-06-22 Updating firmware, clearing out complex LED code
2019-06-22 Removing LED instruction case from MIDI handler
2019-06-22 Adding some simple LED animations
